FranciscoVentures/EN7767/Hardware/GPS.sch

## KiCad design Hardware/GPS.sch (2021-01-12)

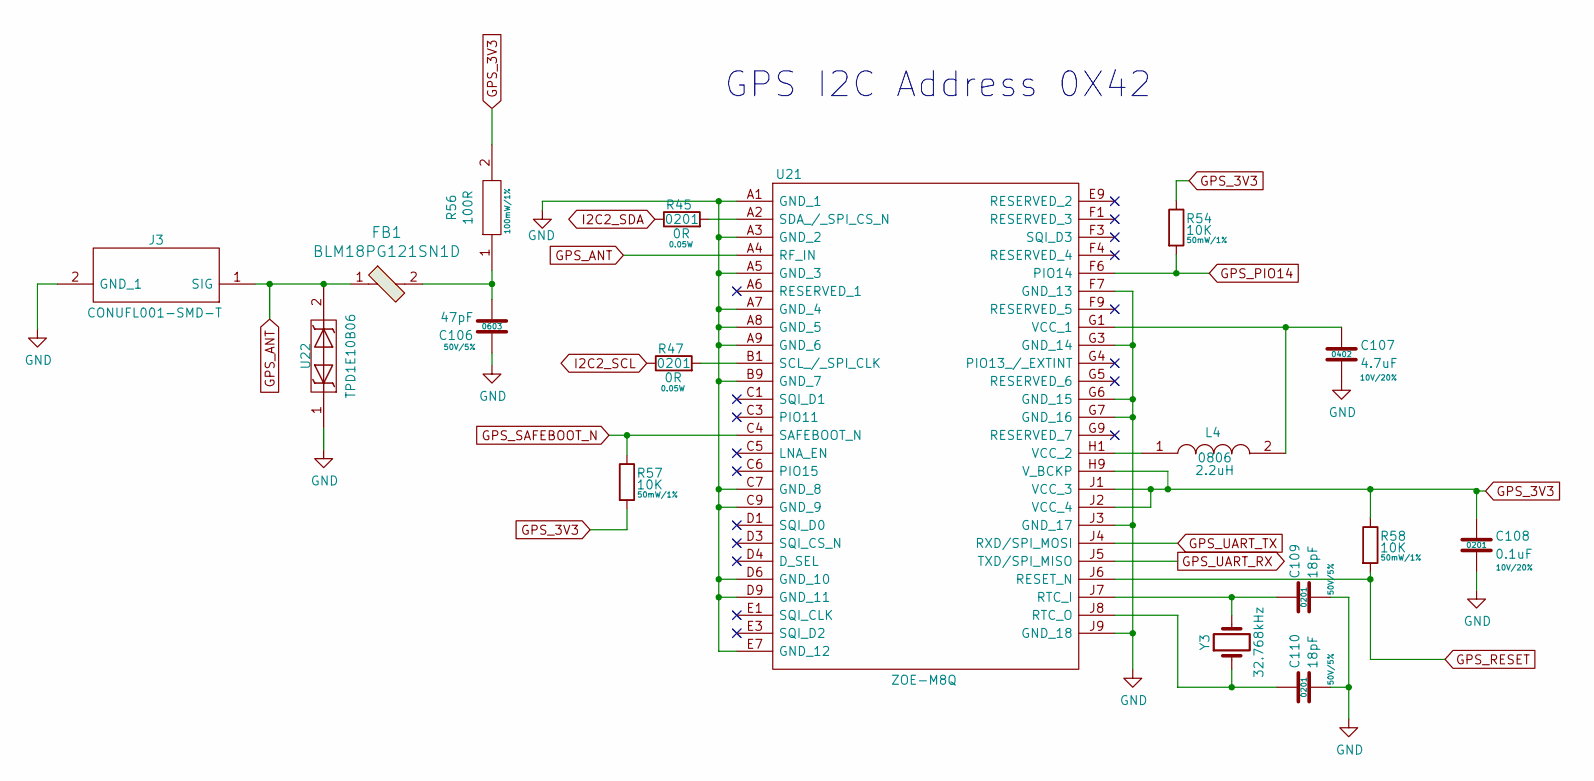
[picture p1: schematic GPS.sch]

Parts:
C106: 47pF; 0603; Rating 50V/5%; Mfg PN C0603C470J5GACTU; Digi-Key_PN 399-1056-1-ND
C107: 4.7uF; SM0402; Rating 10V/20%; Mfg PN ZRB15XR61A475ME01D; Digi-Key_PN 490-10984-1-ND
C108: 0.1uF; SM0201; Rating 10V/20%; Mfg PN GRM033R61A104ME15D; Digi-Key_PN 490-5405-1-ND
C109, C110: 18pF; SM0201; Rating 50V/5%; Mfg PN GRM0335C1H180JA01D; Digi-Key_PN 490-6117-1-ND
FB1: BLM18PG121SN1D; 0603; Mfg PN BLM18PG121SN1D; Digi-Key_PN 490-1037-1-ND
J3: CONUFL001-SMD-T; U.FL_Molex_MCRF_73412-0110_Vertical; Mouser Part Number 712-CONUFL001-SMD-T
L4: 2.2uH; INDC2016X180N; Rating 0806; Mfg PN LQM2MPN2R2NG0L; Digi-Key_PN 490-7786-1-ND
R45, R47: 0R; R_0201_0603Metric; Rating 0.05W; Mfg PN CRCW02010000Z0ED; Digi-Key_PN 541-0.0AGCT-ND
R54, R57, R58: 10K; R_0201_0603Metric; Rating 50mW/1%; Mfg PN CRCW020110K0JNED; Digi-Key_PN 541-10KAGCT-ND
R56: 100R; 0603; Rating 100mW/1%; Mfg PN RC0603FR-07100RL; Digi-Key_PN 311-100HRCT-ND
U21: ZOE-M8Q; ZOEM8B; Mfg PN ZOE-M8Q-0-10; Digi-Key_PN 672-ZOE-M8Q-0-10CT-ND
U22: TPD1E10B06; X1SON-2; Mfg PN TPD1E10B06DPYR; Digi-Key_PN 296-30406-1-ND
Y3: 32.768kHz; CM7V-T1A; Mfg PN CM7V-T1A-32.768KHZ-12.5PF-20PPM-TB-QA; Digi-Key_PN 2195-CM7V-T1A-32.768KHZ-12.5PF-20PPM-TB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

Connections:
GND: C106.1, C107.2, C108.2, C109.2, C110.2, J3.2 (GND_1), U21.A1 (GND_1), U21.A3 (GND_2), U21.A5 (GND_3), U21.A7 (GND_4), U21.A8 (GND_5), U21.A9 (GND_6), U21.B9 (GND_7), U21.C7 (GND_8), U21.C9 (GND_9), U21.D6 (GND_10), U21.D9 (GND_11), U21.E7 (GND_12), U21.F7 (GND_13), U21.G3 (GND_14), U21.G6 (GND_15), U21.G7 (GND_16), U21.J3 (GND_17), U21.J9 (GND_18), U22.1
GPS_3V3: C108.1, R54.1, R56.2, R57.2, R58.1, U21.H9 (V_BCKP), U21.J1 (VCC_3), U21.J2 (VCC_4)
GPS_ANT: FB1.1, J3.1 (SIG), U21.A4 (RF_IN), U22.2
GPS_PIO14: R54.2, U21.F6 (PIO14)
GPS_RESET: R58.2, U21.J6 (RESET_N)
GPS_SAFEBOOT_N: R57.1, U21.C4 (SAFEBOOT_N)
GPS_UART_RX: U21.J5 (TXD/SPI_MISO)
GPS_UART_TX: U21.J4 (RXD/SPI_MOSI)
I2C2_SCL: R47.1
I2C2_SDA: R45.1
unnamed: C106.2, FB1.2, R56.1
unnamed: C107.1, L4.2, U21.G1 (VCC_1)
unnamed: C109.1, U21.J7 (RTC_I), Y3.2
unnamed: C110.1, U21.J8 (RTC_O), Y3.1
unnamed: L4.1, U21.H1 (VCC_2)
unnamed: R45.2, U21.A2 (SDA_/_SPI_CS_N)
unnamed: R47.2, U21.B1 (SCL_/_SPI_CLK)

Notes on the sheet:
GPS I2C Address 0X42
