FranciscoVentures/EN7767/Hardware/boot.sch

## KiCad design Hardware/boot.sch (2021-01-12)

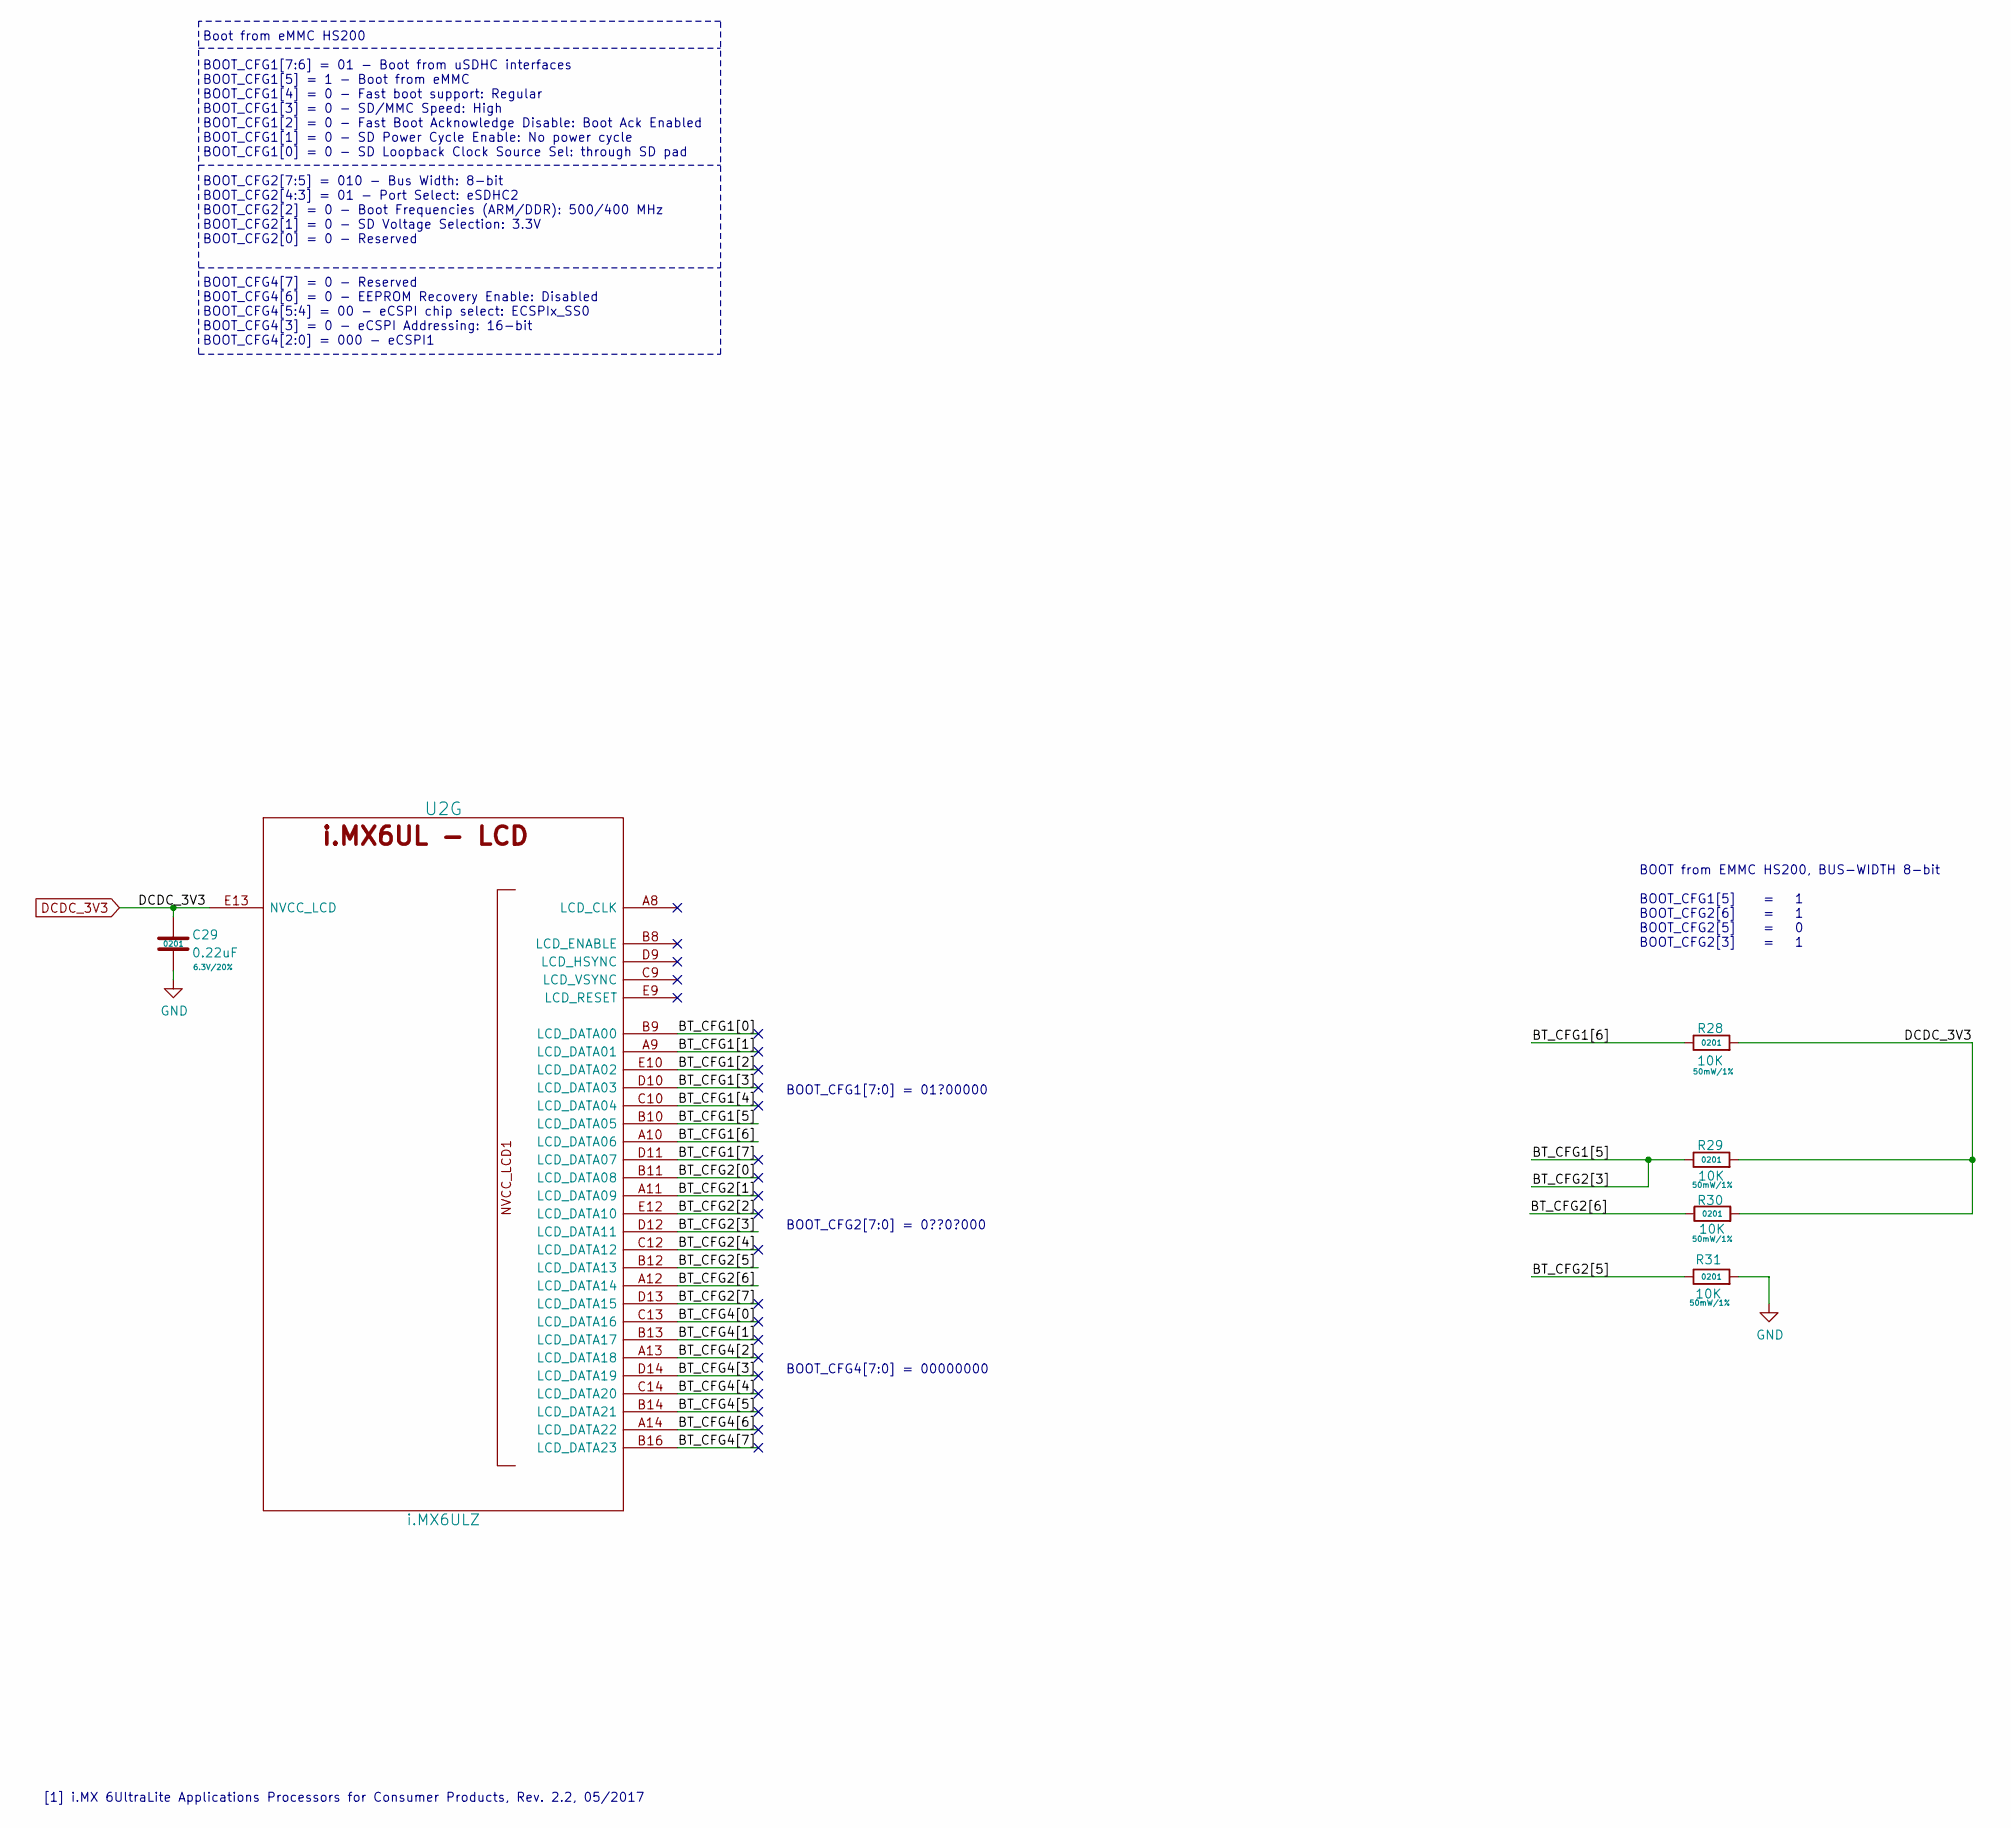
[picture p2: schematic boot.sch]

Parts:
C29: 0.22uF; SM0201; Rating 6.3V/20%; Mfg PN GRM033R60J224ME15D; Digi-Key_PN 490-10407-1-ND
R28, R29, R30, R31: 10K; R_0201_0603Metric; Rating 50mW/1%; Mfg PN CRCW020110K0JNED; Digi-Key_PN 541-10KAGCT-ND
U2: i.MX6ULZ; SOT1534-2; Mfg PN MCIMX6Z0DVM09AB; Digi-Key_PN 568-14726-ND

Connections:
BT_CFG1[0]: U2.B9 (LCD_DATA00)
BT_CFG1[1]: U2.A9 (LCD_DATA01)
BT_CFG1[2]: U2.E10 (LCD_DATA02)
BT_CFG1[3]: U2.D10 (LCD_DATA03)
BT_CFG1[4]: U2.C10 (LCD_DATA04)
BT_CFG1[5]: R29.1, U2.B10 (LCD_DATA05), U2.D12 (LCD_DATA11)
BT_CFG1[6]: R28.1, U2.A10 (LCD_DATA06)
BT_CFG1[7]: U2.D11 (LCD_DATA07)
BT_CFG2[0]: U2.B11 (LCD_DATA08)
BT_CFG2[1]: U2.A11 (LCD_DATA09)
BT_CFG2[2]: U2.E12 (LCD_DATA10)
BT_CFG2[4]: U2.C12 (LCD_DATA12)
BT_CFG2[5]: R31.1, U2.B12 (LCD_DATA13)
BT_CFG2[6]: R30.1, U2.A12 (LCD_DATA14)
BT_CFG2[7]: U2.D13 (LCD_DATA15)
BT_CFG4[0]: U2.C13 (LCD_DATA16)
BT_CFG4[1]: U2.B13 (LCD_DATA17)
BT_CFG4[2]: U2.A13 (LCD_DATA18)
BT_CFG4[3]: U2.D14 (LCD_DATA19)
BT_CFG4[4]: U2.C14 (LCD_DATA20)
BT_CFG4[5]: U2.B14 (LCD_DATA21)
BT_CFG4[6]: U2.A14 (LCD_DATA22)
BT_CFG4[7]: U2.B16 (LCD_DATA23)
DCDC_3V3: C29.1, R28.2, R29.2, R30.2, U2.E13 (NVCC_LCD)
GND: C29.2, R31.2

Notes on the sheet:
Boot from eMMC HS200 BOOT_CFG1[7:6] = 01 - Boot from uSDHC interfaces BOOT_CFG1[5] = 1 - Boot from eMMC BOOT_CFG1[4] = 0 - Fast boot support: Regular BOOT_CFG1[3] = 0 - SD/MMC Speed: High BOOT_CFG1[2] = 0 - Fast Boot Acknowledge Disable: Boot Ack Enabled BOOT_CFG1[1] = 0 - SD Power Cycle Enable: No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
BOOT_CFG4[7:0] = 00000000
BOOT from EMMC HS200, BUS-WIDTH 8-bit BOOT_CFG1[5] = 1 BOOT_CFG2[6] = 1 BOOT_CFG2[5] = 0 BOOT_CFG2[3] = 1
BOOT_CFG2[7:0] = 0??0?000
BOOT_CFG1[7:0] = 01?00000
[1] i.MX 6UltraLite Applications Processors for Consumer Products, Rev. 2.2, 05/2017
