FranciscoVentures/EN7767/Hardware/crystals.sch

## KiCad design Hardware/crystals.sch (2021-01-12)

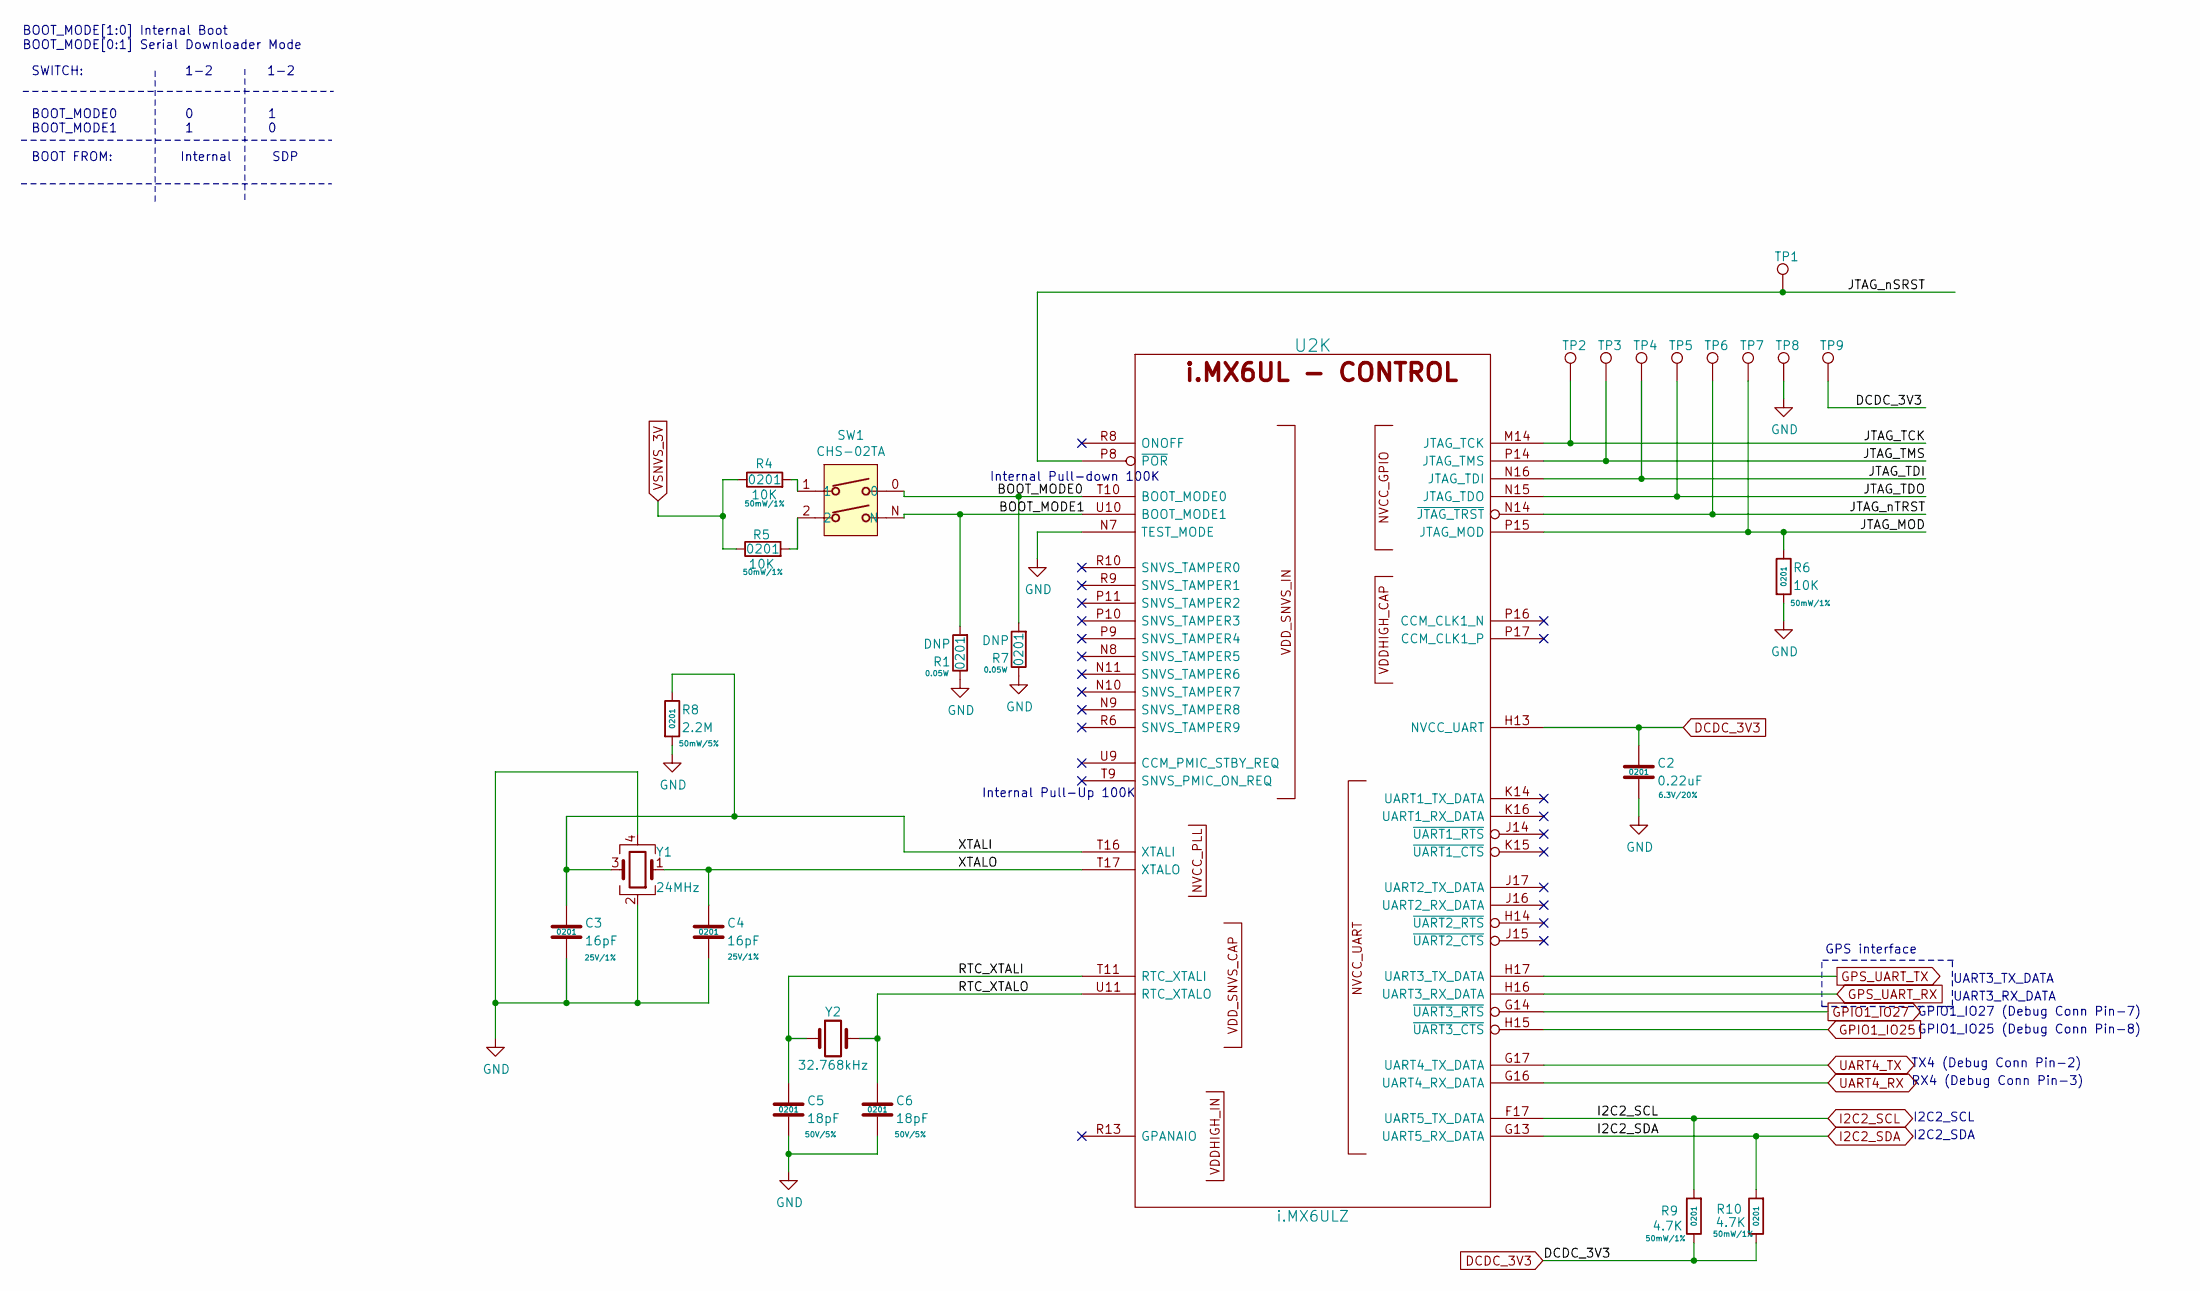
[picture p3: schematic crystals.sch]

Parts:
C2: 0.22uF; SM0201; Rating 6.3V/20%; Mfg PN GRM033R60J224ME15D; Digi-Key_PN 490-10407-1-ND
C3, C4: 16pF; SM0201; Rating 25V/1%; Mfg PN CBR02C160F3GAC; Digi-Key_PN 399-8574-1-ND
C5, C6: 18pF; SM0201; Rating 50V/5%; Mfg PN GRM0335C1H180JA01D; Digi-Key_PN 490-6117-1-ND
R1, R7: DNP; R_0201_0603Metric; Rating 0.05W; Mfg PN CRCW02010000Z0ED; Digi-Key_PN 541-0.0AGCT-ND
R4, R5, R6: 10K; R_0201_0603Metric; Rating 50mW/1%; Mfg PN CRCW020110K0JNED; Digi-Key_PN 541-10KAGCT-ND
R8: 2.2M; R_0201_0603Metric; Rating 50mW/5%; Mfg PN RC0201JR-072M2L; Digi-Key_PN YAG2882CT-ND
R9, R10: 4.7K; R_0201_0603Metric; Rating 50mW/1%; Mfg PN CRCW02014K70JNED; Digi-Key_PN 541-4.7KAGCT-ND
SW1: CHS-02TA; Mfg PN CHS-02TA; Digi-Key_PN 563-1005-2-ND
TP1, TP2, TP3, TP4, TP5, TP6, TP7, TP8, TP9: TestPoint; TP
U2: i.MX6ULZ; SOT1534-2; Mfg PN MCIMX6Z0DVM09AB; Digi-Key_PN 568-14726-ND
Y1: 24MHz; TSX-3225; Mfg PN TSX-3225 24.0000MF15X-AC3; Digi-Key_PN SER3635TR-ND
Y2: 32.768kHz; CM7V-T1A; Mfg PN CM7V-T1A-32.768KHZ-12.5PF-20PPM-TB-QA; Digi-Key_PN 2195-CM7V-T1A-32.768KHZ-12.5PF-20PPM-TB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

Connections:
BOOT_MODE0: R7.2, SW1.0, U2.T10 (BOOT_MODE0)
BOOT_MODE1: R1.2, SW1.N, U2.U10 (BOOT_MODE1)
DCDC_3V3: C2.1, R9.1, R10.1, TP9.1, U2.H13 (NVCC_UART)
GND: C2.2, C3.2, C4.2, C5.2, C6.2, R1.1, R6.2, R7.1, R8.2, TP8.1, U2.N7 (TEST_MODE), Y1.2, Y1.4
GPIO1_IO25: U2.H15 (~UART3_CTS)
GPIO1_IO27: U2.G14 (~UART3_RTS)
GPS_UART_RX: U2.H16 (UART3_RX_DATA)
GPS_UART_TX: U2.H17 (UART3_TX_DATA)
I2C2_SCL: R9.2, U2.F17 (UART5_TX_DATA)
I2C2_SDA: R10.2, U2.G13 (UART5_RX_DATA)
JTAG_MOD: R6.1, TP7.1, U2.P15 (JTAG_MOD)
JTAG_TCK: TP2.1, U2.M14 (JTAG_TCK)
JTAG_TDI: TP4.1, U2.N16 (JTAG_TDI)
JTAG_TDO: TP5.1, U2.N15 (JTAG_TDO)
JTAG_TMS: TP3.1, U2.P14 (JTAG_TMS)
JTAG_nSRST: TP1.1, U2.P8 (~POR)
JTAG_nTRST: TP6.1, U2.N14 (~JTAG_TRST)
unnamed: R4.2, SW1.1
unnamed: R5.2, SW1.2
RTC_XTALI: C5.1, U2.T11 (RTC_XTALI), Y2.1
RTC_XTALO: C6.1, U2.U11 (RTC_XTALO), Y2.2
UART4_RX: U2.G16 (UART4_RX_DATA)
UART4_TX: U2.G17 (UART4_TX_DATA)
VSNVS_3V: R4.1, R5.1
XTALI: C3.1, R8.1, U2.T16 (XTALI), Y1.3
XTALO: C4.1, U2.T17 (XTALO), Y1.1

Notes on the sheet:
BOOT_MODE[1:0] Internal Boot BOOT_MODE[0:1] Serial Downloader Mode
GPS interface
UART3_TX_DATA
UART3_RX_DATA
SWITCH: 1-2 1-2 BOOT_MODE0 0 1 BOOT_MODE1 1 0 BOOT FROM: Internal SDP
GPIO1_IO27 (Debug Conn Pin-7)
RX4 (Debug Conn Pin-3)
TX4 (Debug Conn Pin-2)
I2C2_SDA
I2C2_SCL
Internal Pull-down 100K
Internal Pull-Up 100K
GPIO1_IO25 (Debug Conn Pin-8)
