FranciscoVentures/EN7767/Hardware/ddr.sch

## KiCad design Hardware/ddr.sch (2021-01-12)

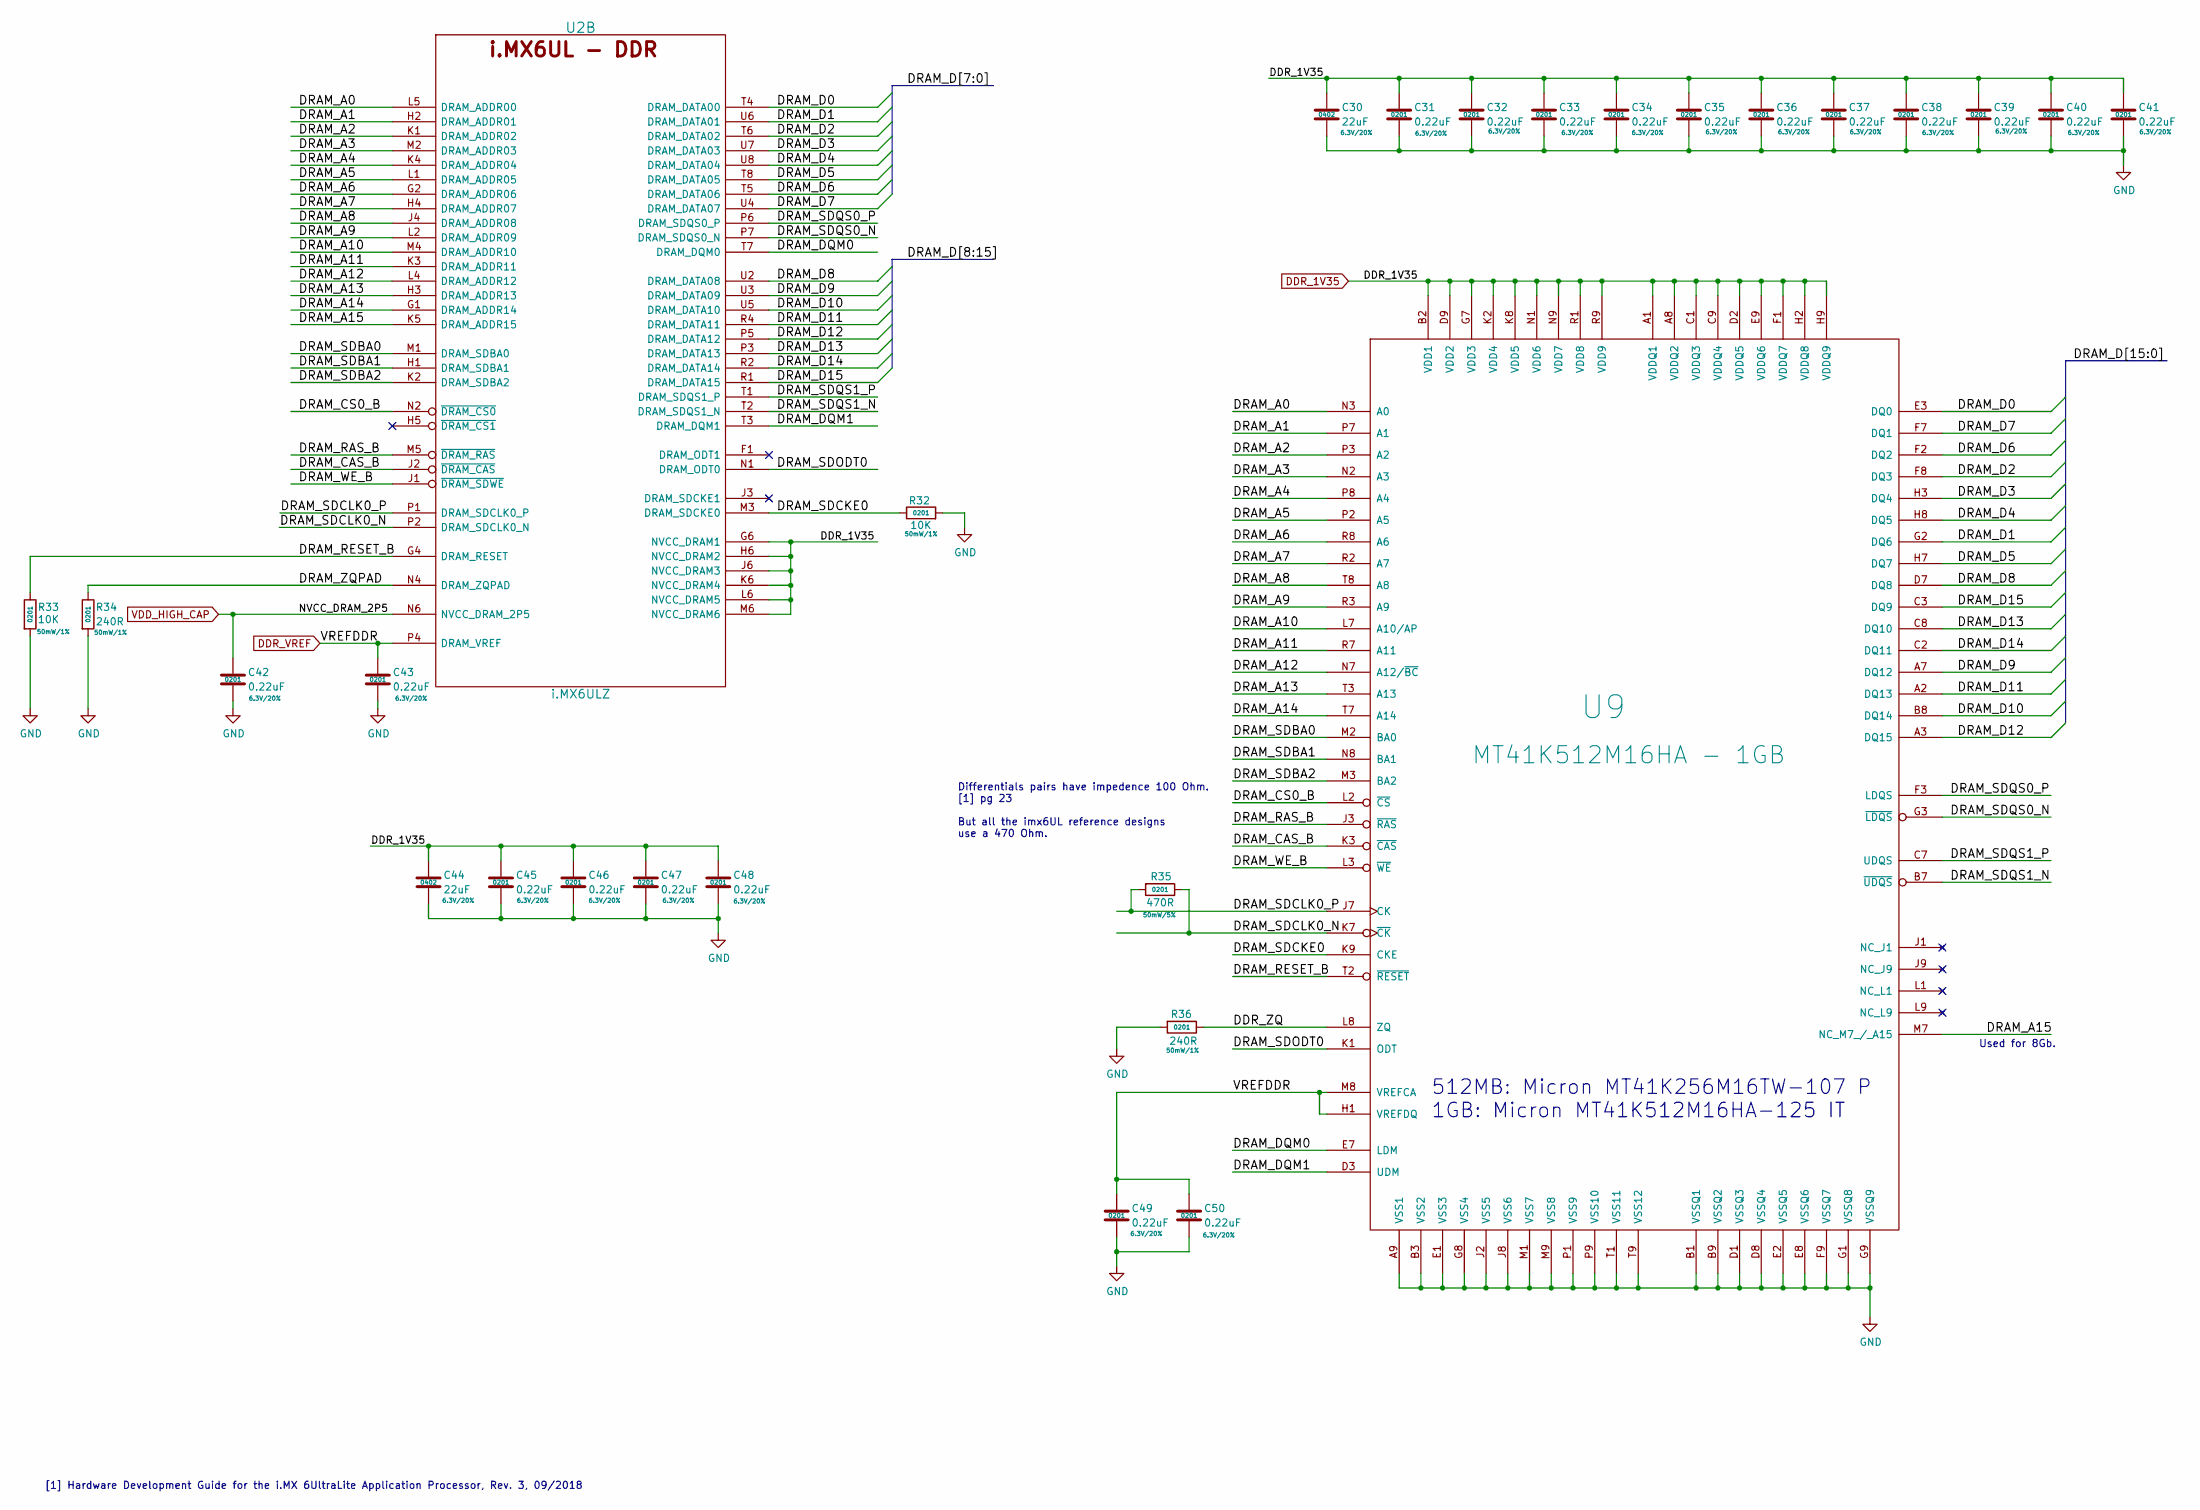
[picture p4: schematic ddr.sch]

Parts:
C30, C44: 22uF; SM0402; Rating 6.3V/20%; Mfg PN CL05A226MQ5N6J8; Digi-Key_PN 1276-7090-1-ND
C31, C32, C33, C34, C35, C36, C37, C38, C39, C40, C41, C42, C43, C45, C46, C47, C48, C49, C50: 0.22uF; SM0201; Rating 6.3V/20%; Mfg PN GRM033R60J224ME15D; Digi-Key_PN 490-10407-1-ND
R32, R33: 10K; R_0201_0603Metric; Rating 50mW/1%; Mfg PN CRCW020110K0JNED; Digi-Key_PN 541-10KAGCT-ND
R34, R36: 240R; R_0201_0603Metric; Rating 50mW/1%; Mfg PN CRCW0201240RFNED; Digi-Key_PN 541-2949-1-ND
R35: 470R; R_0201_0603Metric; Rating 50mW/5%; Mfg PN CRCW0201470RJNED; Digi-Key_PN 541-470AGCT-ND
U2: i.MX6ULZ; SOT1534-2; Mfg PN MCIMX6Z0DVM09AB; Digi-Key_PN 568-14726-ND
U9: MT41K512M16HA - 1GB; MICRON-FBGA-96; Mfg PN MT41K512M16HA-125 IT:A; Digi-Key_PN MT41K512M16HA-125IT:A-ND

Connections:
DDR_1V35: C30.1, C31.1, C32.1, C33.1, C34.1, C35.1, C36.1, C37.1, C38.1, C39.1, C40.1, C41.1, C44.1, C45.1, C46.1, C47.1, C48.1, U2.G6 (NVCC_DRAM1), U2.H6 (NVCC_DRAM2), U2.J6 (NVCC_DRAM3), U2.K6 (NVCC_DRAM4), U2.L6 (NVCC_DRAM5), U2.M6 (NVCC_DRAM6), U9.A1 (VDDQ1), U9.A8 (VDDQ2), U9.B2 (VDD1), U9.C1 (VDDQ3), U9.C9 (VDDQ4), U9.D2 (VDDQ5), U9.D9 (VDD2), U9.E9 (VDDQ6), U9.F1 (VDDQ7), U9.G7 (VDD3), U9.H2 (VDDQ8), U9.H9 (VDDQ9), U9.K2 (VDD4), U9.K8 (VDD5), U9.N1 (VDD6), U9.N9 (VDD7), U9.R1 (VDD8), U9.R9 (VDD9)
DDR_VREF: C43.1, C49.1, C50.1, U2.P4 (DRAM_VREF), U9.H1 (VREFDQ), U9.M8 (VREFCA)
DDR_ZQ: R36.1, U9.L8 (ZQ)
DRAM_A0: U2.L5 (DRAM_ADDR00), U9.N3 (A0)
DRAM_A1: U2.H2 (DRAM_ADDR01), U9.P7 (A1)
DRAM_A2: U2.K1 (DRAM_ADDR02), U9.P3 (A2)
DRAM_A3: U2.M2 (DRAM_ADDR03), U9.N2 (A3)
DRAM_A4: U2.K4 (DRAM_ADDR04), U9.P8 (A4)
DRAM_A5: U2.L1 (DRAM_ADDR05), U9.P2 (A5)
DRAM_A6: U2.G2 (DRAM_ADDR06), U9.R8 (A6)
DRAM_A7: U2.H4 (DRAM_ADDR07), U9.R2 (A7)
DRAM_A8: U2.J4 (DRAM_ADDR08), U9.T8 (A8)
DRAM_A9: U2.L2 (DRAM_ADDR09), U9.R3 (A9)
DRAM_A10: U2.M4 (DRAM_ADDR10), U9.L7 (A10/AP)
DRAM_A11: U2.K3 (DRAM_ADDR11), U9.R7 (A11)
DRAM_A12: U2.L4 (DRAM_ADDR12), U9.N7 (A12/~BC)
DRAM_A13: U2.H3 (DRAM_ADDR13), U9.T3 (A13)
DRAM_A14: U2.G1 (DRAM_ADDR14), U9.T7 (A14)
DRAM_A15: U2.K5 (DRAM_ADDR15), U9.M7 (NC_M7_/_A15)
DRAM_CAS_B: U2.J2 (~DRAM_CAS), U9.K3 (~CAS)
DRAM_CS0_B: U2.N2 (~DRAM_CS0), U9.L2 (~CS)
DRAM_D0: U2.T4 (DRAM_DATA00), U9.E3 (DQ0)
DRAM_D1: U2.U6 (DRAM_DATA01), U9.G2 (DQ6)
DRAM_D2: U2.T6 (DRAM_DATA02), U9.F8 (DQ3)
DRAM_D3: U2.U7 (DRAM_DATA03), U9.H3 (DQ4)
DRAM_D4: U2.U8 (DRAM_DATA04), U9.H8 (DQ5)
DRAM_D5: U2.T8 (DRAM_DATA05), U9.H7 (DQ7)
DRAM_D6: U2.T5 (DRAM_DATA06), U9.F2 (DQ2)
DRAM_D7: U2.U4 (DRAM_DATA07), U9.F7 (DQ1)
DRAM_D8: U2.U2 (DRAM_DATA08), U9.D7 (DQ8)
DRAM_D9: U2.U3 (DRAM_DATA09), U9.A7 (DQ12)
DRAM_D10: U2.U5 (DRAM_DATA10), U9.B8 (DQ14)
DRAM_D11: U2.R4 (DRAM_DATA11), U9.A2 (DQ13)
DRAM_D12: U2.P5 (DRAM_DATA12), U9.A3 (DQ15)
DRAM_D13: U2.P3 (DRAM_DATA13), U9.C8 (DQ10)
DRAM_D14: U2.R2 (DRAM_DATA14), U9.C2 (DQ11)
DRAM_D15: U2.R1 (DRAM_DATA15), U9.C3 (DQ9)
DRAM_DQM0: U2.T7 (DRAM_DQM0), U9.E7 (LDM)
DRAM_DQM1: U2.T3 (DRAM_DQM1), U9.D3 (UDM)
DRAM_RAS_B: U2.M5 (~DRAM_RAS), U9.J3 (~RAS)
DRAM_RESET_B: R33.1, U2.G4 (DRAM_RESET), U9.T2 (~RESET)
DRAM_SDBA0: U2.M1 (DRAM_SDBA0), U9.M2 (BA0)
DRAM_SDBA1: U2.H1 (DRAM_SDBA1), U9.N8 (BA1)
DRAM_SDBA2: U2.K2 (DRAM_SDBA2), U9.M3 (BA2)
DRAM_SDCKE0: R32.1, U2.M3 (DRAM_SDCKE0), U9.K9 (CKE)
DRAM_SDCLK0_N: R35.1, U2.P2 (DRAM_SDCLK0_N), U9.K7 (~CK)
DRAM_SDCLK0_P: R35.2, U2.P1 (DRAM_SDCLK0_P), U9.J7 (CK)
DRAM_SDODT0: U2.N1 (DRAM_ODT0), U9.K1 (ODT)
DRAM_SDQS0_N: U2.P7 (DRAM_SDQS0_N), U9.G3 (~LDQS)
DRAM_SDQS0_P: U2.P6 (DRAM_SDQS0_P), U9.F3 (LDQS)
DRAM_SDQS1_N: U2.T2 (DRAM_SDQS1_N), U9.B7 (~UDQS)
DRAM_SDQS1_P: U2.T1 (DRAM_SDQS1_P), U9.C7 (UDQS)
DRAM_WE_B: U2.J1 (~DRAM_SDWE), U9.L3 (~WE)
DRAM_ZQPAD: R34.1, U2.N4 (DRAM_ZQPAD)
GND: C30.2, C31.2, C32.2, C33.2, C34.2, C35.2, C36.2, C37.2, C38.2, C39.2, C40.2, C41.2, C42.2, C43.2, C44.2, C45.2, C46.2, C47.2, C48.2, C49.2, C50.2, R32.2, R33.2, R34.2, R36.2, U9.A9 (VSS1), U9.B1 (VSSQ1), U9.B3 (VSS2), U9.B9 (VSSQ2), U9.D1 (VSSQ3), U9.D8 (VSSQ4), U9.E1 (VSS3), U9.E2 (VSSQ5), U9.E8 (VSSQ6), U9.F9 (VSSQ7), U9.G1 (VSSQ8), U9.G8 (VSS4), U9.G9 (VSSQ9), U9.J2 (VSS5), U9.J8 (VSS6), U9.M1 (VSS7), U9.M9 (VSS8), U9.P1 (VSS9), U9.P9 (VSS10), U9.T1 (VSS11), U9.T9 (VSS12)
VDD_HIGH_CAP: C42.1, U2.N6 (NVCC_DRAM_2P5)

Notes on the sheet:
Used for 8Gb.
512MB: Micron MT41K256M16TW-107 P 1GB: Micron MT41K512M16HA-125 IT
[1] Hardware Development Guide for the i.MX 6UltraLite Application Processor, Rev. 3, 09/2018
Differentials pairs have impedence 100 Ohm. [1] pg 23 But all the imx6UL reference designs use a 470 Ohm.
