FranciscoVentures/EN7767/Hardware/emmc.sch

## KiCad design Hardware/emmc.sch (2021-01-12)

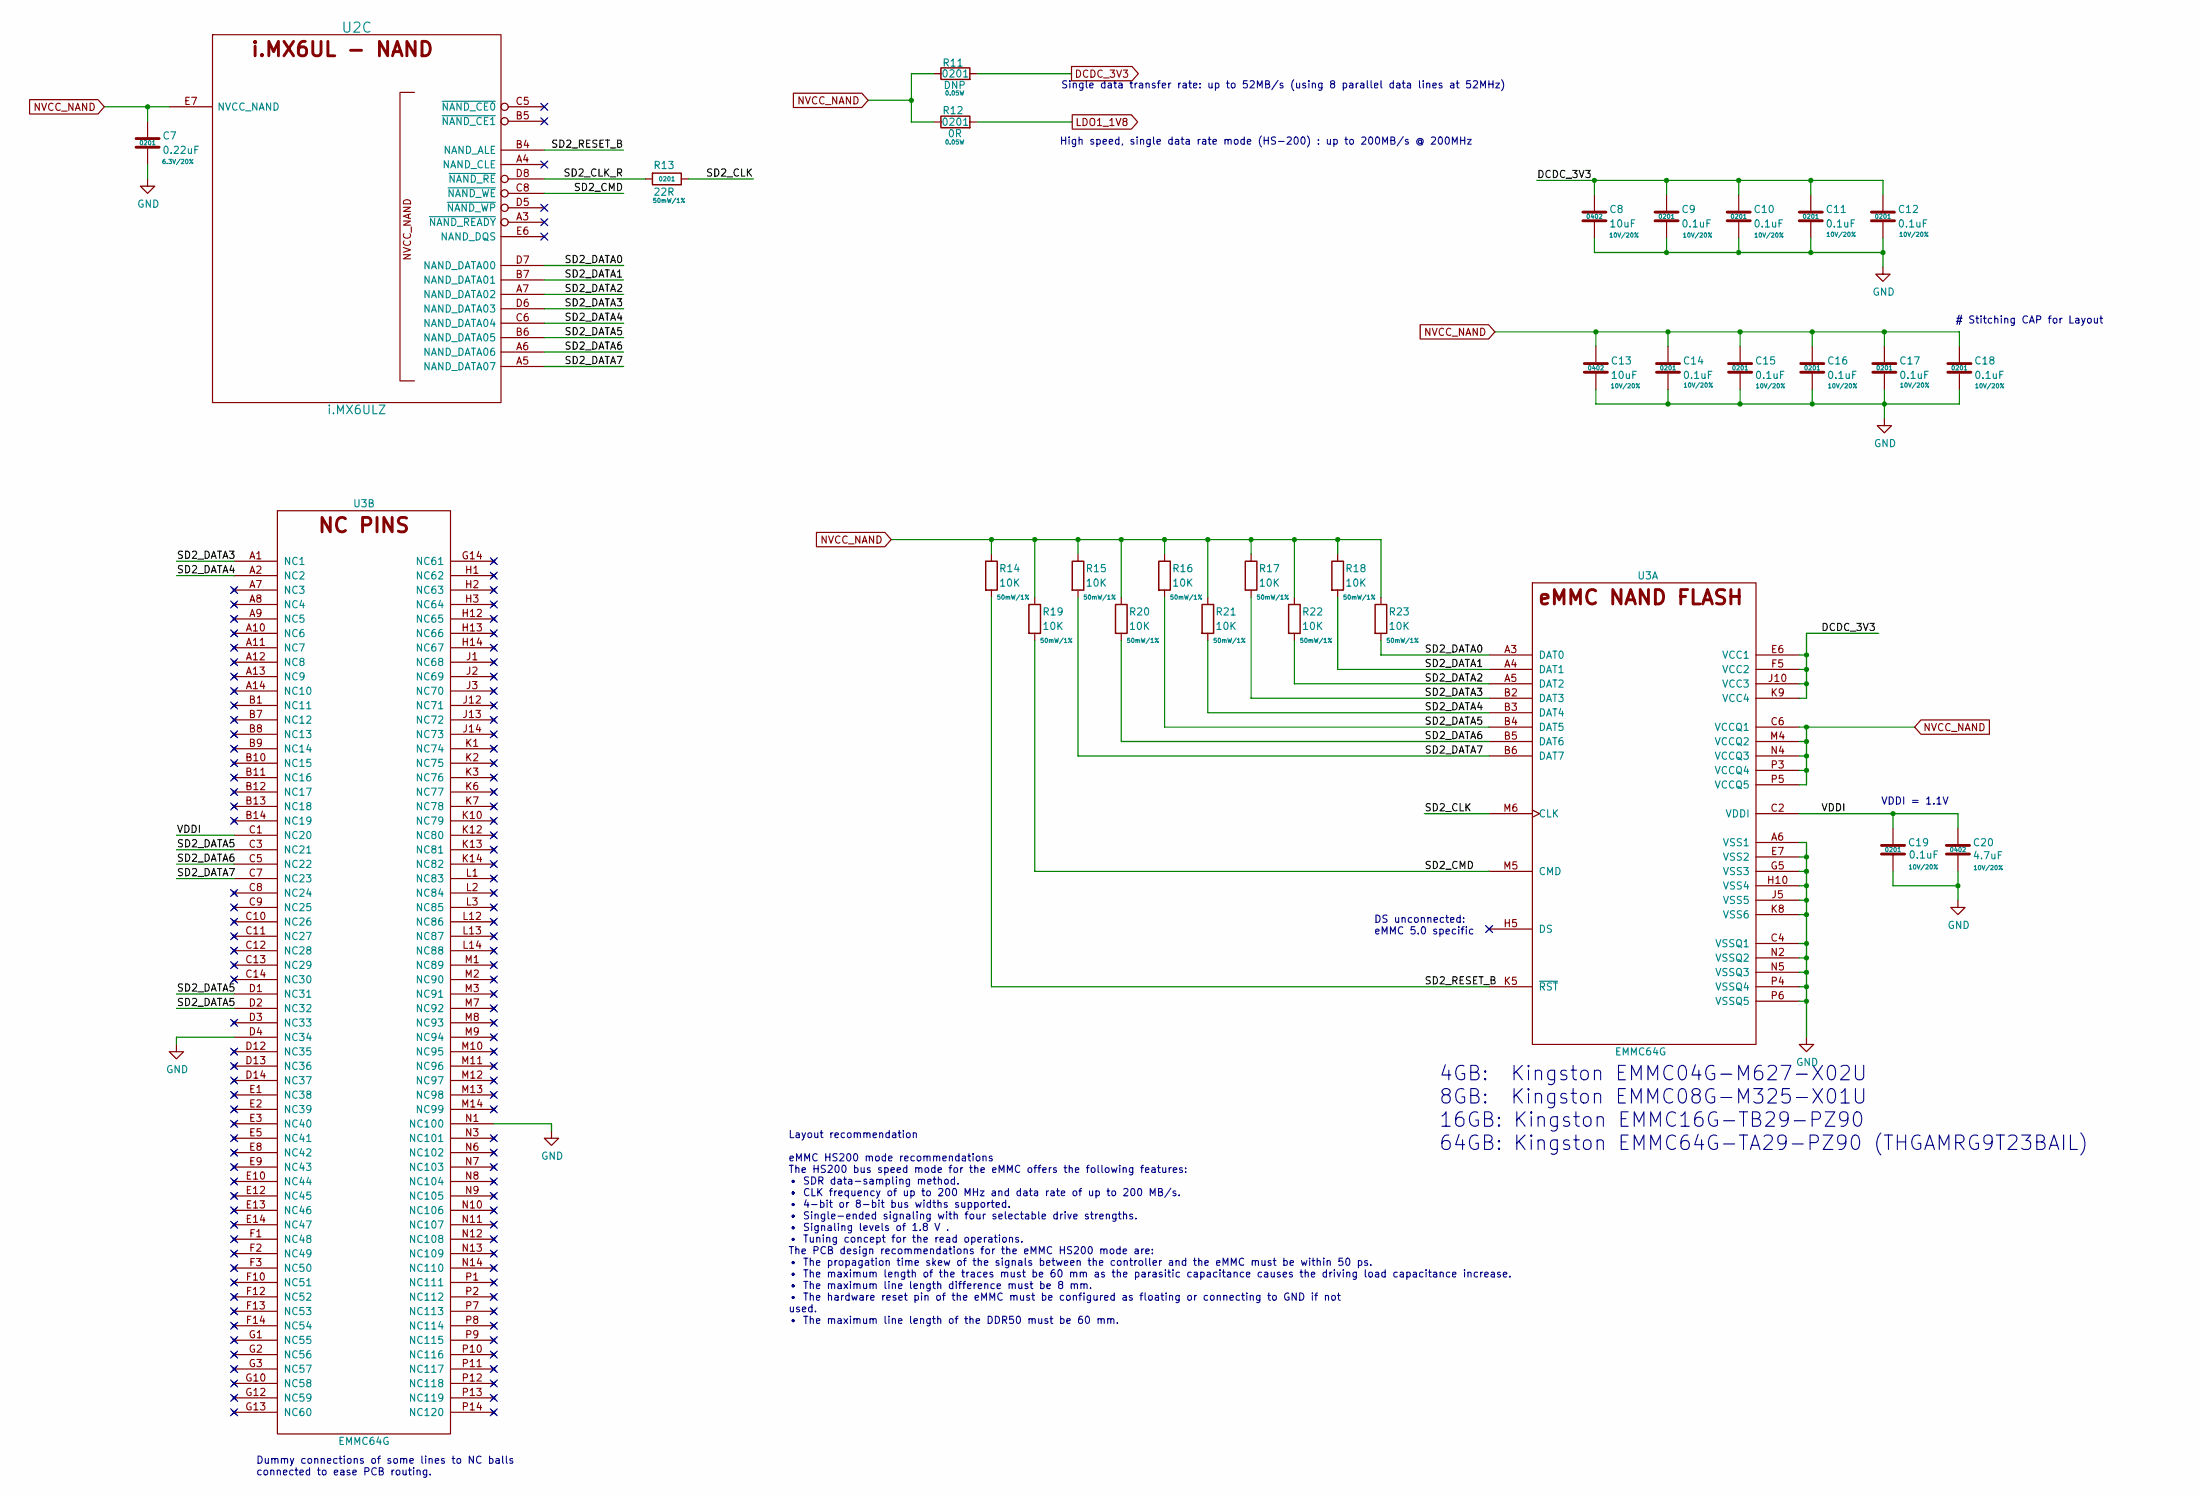
[picture p5: schematic emmc.sch]

Parts:
C7: 0.22uF; SM0201; Rating 6.3V/20%; Mfg PN GRM033R60J224ME15D; Digi-Key_PN 490-10407-1-ND
C8, C13: 10uF; SM0402; Rating 10V/20%; Mfg PN CL05A106MP8NUB8; Digi-Key_PN 1276-6830-1-ND
C9, C10, C11, C12, C14, C15, C16, C17, C18, C19: 0.1uF; SM0201; Rating 10V/20%; Mfg PN GRM033R61A104ME15D; Digi-Key_PN 490-5405-1-ND
C20: 4.7uF; SM0402; Rating 10V/20%; Mfg PN ZRB15XR61A475ME01D; Digi-Key_PN 490-10984-1-ND
R11: DNP; R_0201_0603Metric; Rating 0.05W; Mfg PN CRCW02010000Z0ED; Digi-Key_PN 541-0.0AGCT-ND
R12: 0R; R_0201_0603Metric; Rating 0.05W; Mfg PN CRCW02010000Z0ED; Digi-Key_PN 541-0.0AGCT-ND
R13: 22R; R_0201_0603Metric; Rating 50mW/1%; Mfg PN CRCW020122R0JNED; Digi-Key_PN 541-22AGCT-ND
R14, R15, R16, R17, R18, R19, R20, R21, R22, R23: 10K; R_0201_0603Metric; Rating 50mW/1%; Mfg PN CRCW020110K0JNED; Digi-Key_PN 541-10KAGCT-ND
U2: i.MX6ULZ; SOT1534-2; Mfg PN MCIMX6Z0DVM09AB; Digi-Key_PN 568-14726-ND
U3: EMMC64G; FBGA-153; Mfg PN THGAMRG9T23BAIL; Digi-Key_PN THGAMRG9T23BAIL-ND

Connections:
DCDC_3V3: C8.1, C9.1, C10.1, C11.1, C12.1, R11.2, U3.E6 (VCC1), U3.F5 (VCC2), U3.J10 (VCC3), U3.K9 (VCC4)
GND: C7.2, C8.2, C9.2, C10.2, C11.2, C12.2, C13.2, C14.2, C15.2, C16.2, C17.2, C18.2, C19.2, C20.2, U3.A6 (VSS1), U3.C4 (VSSQ1), U3.D4 (NC34), U3.E7 (VSS2), U3.G5 (VSS3), U3.H10 (VSS4), U3.J5 (VSS5), U3.K8 (VSS6), U3.N1 (NC100), U3.N2 (VSSQ2), U3.N5 (VSSQ3), U3.P4 (VSSQ4), U3.P6 (VSSQ5)
LDO1_1V8: R12.2
NVCC_NAND: C7.1, C13.1, C14.1, C15.1, C16.1, C17.1, C18.1, R11.1, R12.1, R14.1, R15.1, R16.1, R17.1, R18.1, R19.1, R20.1, R21.1, R22.1, R23.1, U2.E7 (NVCC_NAND), U3.C6 (VCCQ1), U3.M4 (VCCQ2), U3.N4 (VCCQ3), U3.P3 (VCCQ4), U3.P5 (VCCQ5)
SD2_CLK: R13.1, U3.M6 (CLK)
SD2_CLK_R: R13.2, U2.D8 (~NAND_RE)
SD2_CMD: R19.2, U2.C8 (~NAND_WE), U3.M5 (CMD)
SD2_DATA0: R23.2, U2.D7 (NAND_DATA00), U3.A3 (DAT0)
SD2_DATA1: R18.2, U2.B7 (NAND_DATA01), U3.A4 (DAT1)
SD2_DATA2: R22.2, U2.A7 (NAND_DATA02), U3.A5 (DAT2)
SD2_DATA3: R17.2, U2.D6 (NAND_DATA03), U3.A1 (NC1), U3.B2 (DAT3)
SD2_DATA4: R21.2, U2.C6 (NAND_DATA04), U3.A2 (NC2), U3.B3 (DAT4)
SD2_DATA5: R16.2, U2.B6 (NAND_DATA05), U3.B4 (DAT5), U3.C3 (NC21), U3.D1 (NC31), U3.D2 (NC32)
SD2_DATA6: R20.2, U2.A6 (NAND_DATA06), U3.B5 (DAT6), U3.C5 (NC22)
SD2_DATA7: R15.2, U2.A5 (NAND_DATA07), U3.B6 (DAT7), U3.C7 (NC23)
SD2_RESET_B: R14.2, U2.B4 (NAND_ALE), U3.K5 (~RST)
VDDI: C19.1, C20.1, U3.C1 (NC20), U3.C2 (VDDI)

Notes on the sheet:
Dummy connections of some lines to NC balls connected to ease PCB routing.
DS unconnected: eMMC 5.0 specific
4GB: Kingston EMMC04G-M627-X02U 8GB: Kingston EMMC08G-M325-X01U 16GB: Kingston EMMC16G-TB29-PZ90 64GB: Kingston EMMC64G-TA29-PZ90 (THGAMRG9T23BAIL)
# Stitching CAP for Layout
High speed, single data rate mode (HS-200) : up to 200MB/s @ 200MHz
Single data transfer rate: up to 52MB/s (using 8 parallel data lines at 52MHz)
Layout recommendation eMMC HS200 mode recommendations The HS200 bus speed mode for the eMMC offers the following features: • SDR data-sampling method. • CLK frequency of up to 200 MHz and data rate of up to 200 MB/s. • 4-bit or 8-bit bus widths supported. • Single-ended signaling with four selectab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
VDDI = 1.1V
