FranciscoVentures/EN7767/Hardware/misc.sch

## KiCad design Hardware/misc.sch (2021-01-12)

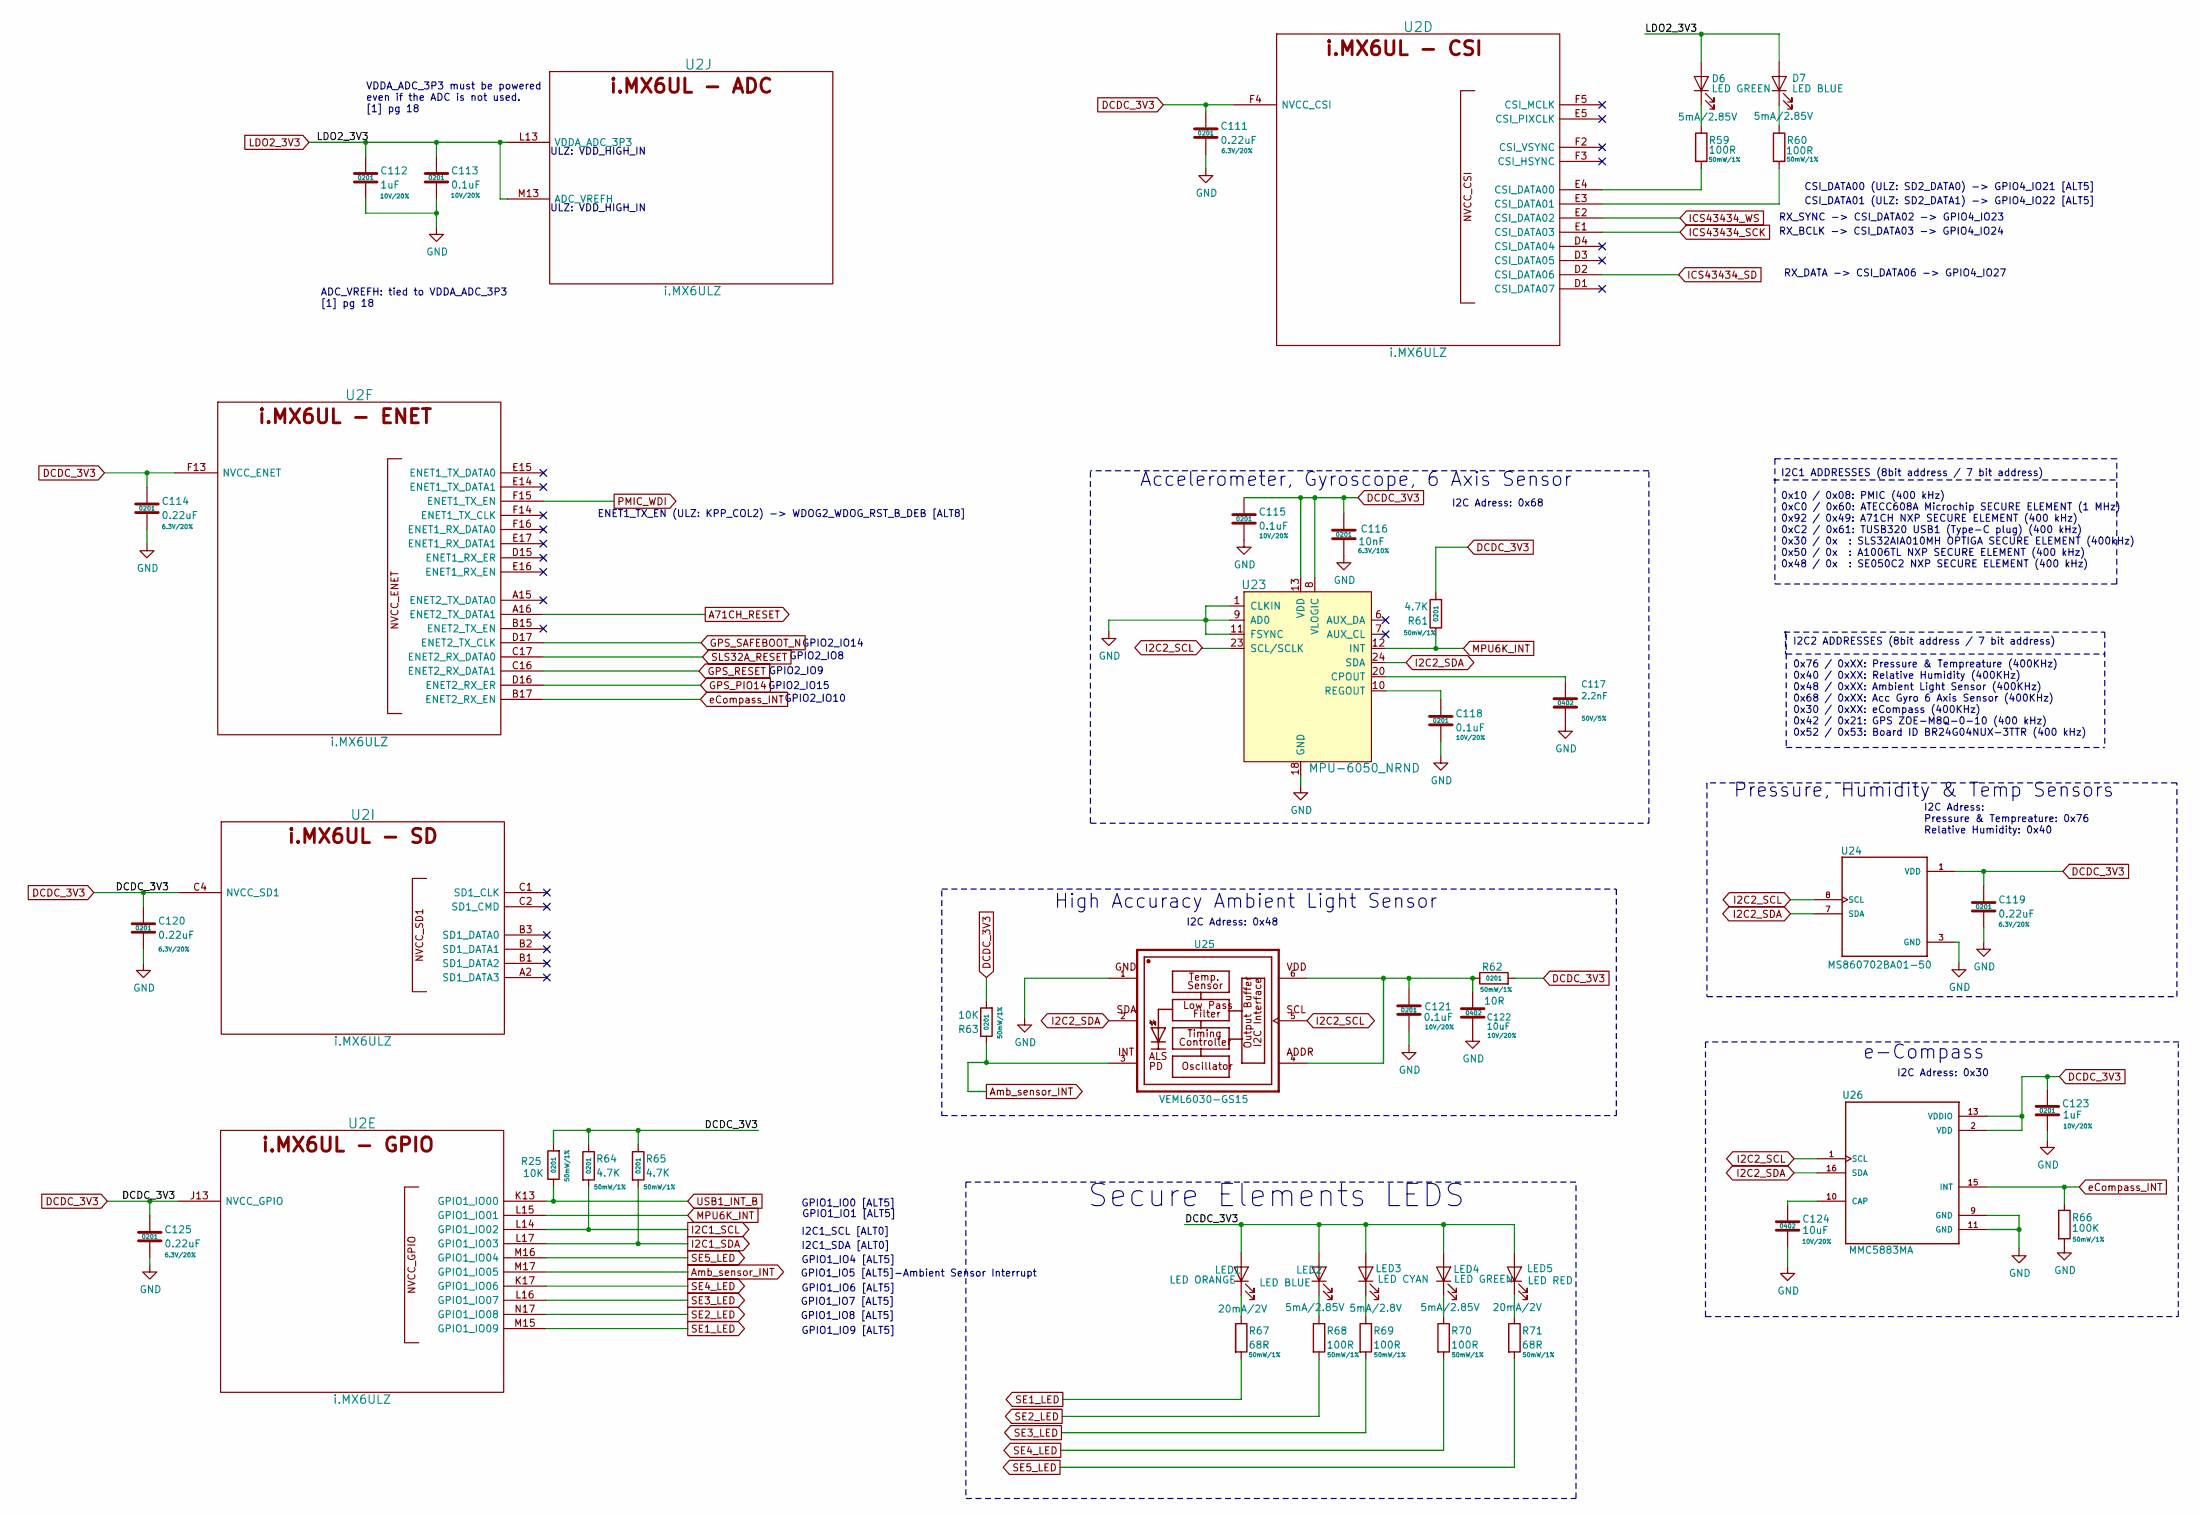
[picture p6: schematic misc.sch]

Parts:
C111, C114, C119, C120, C125: 0.22uF; SM0201; Rating 6.3V/20%; Mfg PN GRM033R60J224ME15D; Digi-Key_PN 490-10407-1-ND
C112, C123: 1uF; SM0201; Rating 10V/20%; Mfg PN CL03A105MP3ZSNH; Digi-Key_PN 1276-6816-1-ND
C113, C115, C118, C121: 0.1uF; SM0201; Rating 10V/20%; Mfg PN GRM033R61A104ME15D; Digi-Key_PN 490-5405-1-ND
C116: 10nF; SM0201; Rating 6.3V/10%; Mfg PN GRM033R70J103KA01D; Digi-Key_PN 490-1262-1-ND
C117: 2.2nF; C_0402_1005Metric; Rating 50V/5%; Mfg PN GRM155R71H222JA01J; Digi-Key_PN 490-6359-1-ND
C122: 10uF; C_0402_1005Metric; Rating 10V/20%; Mfg PN CL05A106MP8NUB8; Digi-Key_PN 1276-6830-1-ND
C124: 10uF; SM0402; Rating 10V/20%; Mfg PN CL05A106MP8NUB8; Digi-Key_PN 1276-6830-1-ND
D6: LED GREEN; LED_0603; Rating 5mA/2.85V; Mfg PN LT Q39G-Q1OO-25-1; Digi-Key_PN 475-3442-1-ND
D7: LED BLUE; SM0603_LED; Rating 5mA/2.85V; Mfg PN LB Q39G-L2OO-35-1; Digi-Key_PN 475-2816-1-ND
LED1: LED ORANGE; LED_0603; Rating 20mA/2V; Mfg PN LO Q976-PS-25-0-20-R18; Digi-Key_PN 475-2486-1-ND
LED2: LED BLUE; LED_0603; Rating 5mA/2.85V; Mfg PN LB Q39G-L2OO-35-1; Digi-Key_PN 475-2816-1-ND
LED3: LED CYAN; LED_0603; Rating 5mA/2.8V; Mfg PN APT1608VRCXF/A-5MAV; Digi-Key_PN 754-2180-1-ND
LED4: LED GREEN; LED_0603; Rating 5mA/2.85V; Mfg PN LT Q39G-Q1OO-25-1; Digi-Key_PN 475-3442-1-ND
LED5: LED RED; LED_0603; Rating 20mA/2V; Mfg PN LS Q976-NR-1; Digi-Key_PN 475-2512-1-ND
R25, R63: 10K; R_0201_0603Metric; Rating 50mW/1%; Mfg PN CRCW020110K0JNED; Digi-Key_PN 541-10KAGCT-ND
R59, R60, R68, R69, R70: 100R; R_0201_0603Metric; Rating 50mW/1%; Mfg PN CRCW0201100RFNED; Digi-Key_PN 541-100ABCT-ND
R61, R64, R65: 4.7K; R_0201_0603Metric; Rating 50mW/1%; Mfg PN CRCW02014K70JNED; Digi-Key_PN 541-4.7KAGCT-ND
R62: 10R; R_0201_0603Metric; Rating 50mW/1%; Mfg PN CRCW020110R0FNED; Digi-Key_PN 541-10.0ABCT-ND
R66: 100K; R_0201_0603Metric; Rating 50mW/1%; Mfg PN CRCW0201100KJNED; Digi-Key_PN 541-100KAGCT-ND
R67, R71: 68R; R_0201_0603Metric; Rating 50mW/1%; Mfg PN CRCW020168R0FNED; Digi-Key_PN 541-CRCW020168R0FNEDCT-ND
U2: i.MX6ULZ; SOT1534-2; Mfg PN MCIMX6Z0DVM09AB; Digi-Key_PN 568-14726-ND
U23: MPU-6050_NRND; QFN-24-1EP_4x4mm; Mfg PN MPU-6050; Digi-Key_PN 1428-1007-1-ND
U24: MS860702BA01-50; TE_MS860702BA01-50; Mfg PN MS860702BA01-50; Digi-Key_PN 223-1701-1-ND
U25: VEML6030-GS15; VISHAY_VEML6030_2X2X0.87; Mfg PN VEML6030-GS15; Digi-Key_PN VEML6030-GS15CT-ND
U26: MMC5883MA; PQFN50P300X300X100-16N; Mfg PN MMC5883MA; Digi-Key_PN 1267-1072-1-ND

Connections:
A71CH_RESET: U2.A16 (ENET2_TX_DATA1)
Amb_sensor_INT: R63.1, U2.M17 (GPIO1_IO05), U25.3
DCDC_3V3: C111.1, C114.1, C115.1, C116.1, C119.1, C120.1, C123.1, C125.1, LED1.2 (A), LED2.2 (A), LED3.2 (A), LED4.2 (A), LED5.2 (A), R25.2, R61.2, R62.2, R63.2, R64.1, R65.1, U2.C4 (NVCC_SD1), U2.F4 (NVCC_CSI), U2.F13 (NVCC_ENET), U2.J13 (NVCC_GPIO), U23.8 (VLOGIC), U23.13 (VDD), U24.1 (VDD), U26.2 (VDD), U26.13 (VDDIO)
GND: C111.2, C112.2, C113.2, C114.2, C115.2, C116.2, C117.2, C118.2, C119.2, C120.2, C121.2, C122.2, C123.2, C124.2, C125.2, R66.2, U23.1 (CLKIN), U23.9 (AD0), U23.11 (FSYNC), U23.18 (GND), U24.3 (GND), U25.1, U26.9 (GND), U26.11 (GND)
GPS_PIO14: U2.D16 (ENET2_RX_ER)
GPS_RESET: U2.C16 (ENET2_RX_DATA1)
GPS_SAFEBOOT_N: U2.D17 (ENET2_TX_CLK)
I2C1_SCL: R64.2, U2.L14 (GPIO1_IO02)
I2C1_SDA: R65.2, U2.L17 (GPIO1_IO03)
I2C2_SCL: U23.23 (SCL/SCLK), U24.8 (SCL), U25.5, U26.1 (SCL)
I2C2_SDA: U23.24 (SDA), U24.7 (SDA), U25.2, U26.16 (SDA)
ICS43434_SCK: U2.E1 (CSI_DATA03)
ICS43434_SD: U2.D2 (CSI_DATA06)
ICS43434_WS: U2.E2 (CSI_DATA02)
LDO2_3V3: C112.1, C113.1, D6.2 (A), D7.2 (A), U2.L13 (VDDA_ADC_3P3), U2.M13 (ADC_VREFH)
MPU6K_INT: R61.1, U2.L15 (GPIO1_IO01), U23.12 (INT)
unnamed: C117.1, U23.20 (CPOUT)
unnamed: C118.1, U23.10 (REGOUT)
unnamed: C121.1, C122.1, R62.1, U25.4, U25.6
unnamed: C124.1, U26.10 (CAP)
unnamed: D6.1 (K), R59.1
unnamed: D7.1 (K), R60.1
unnamed: LED1.1 (K), R67.1
unnamed: LED2.1 (K), R68.1
unnamed: LED3.1 (K), R69.1
unnamed: LED4.1 (K), R70.1
unnamed: LED5.1 (K), R71.1
unnamed: R59.2, U2.E4 (CSI_DATA00)
unnamed: R60.2, U2.E3 (CSI_DATA01)
PMIC_WDI: U2.F15 (ENET1_TX_EN)
SE1_LED: R67.2, U2.M15 (GPIO1_IO09)
SE2_LED: R68.2, U2.N17 (GPIO1_IO08)
SE3_LED: R69.2, U2.L16 (GPIO1_IO07)
SE4_LED: R70.2, U2.K17 (GPIO1_IO06)
SE5_LED: R71.2, U2.M16 (GPIO1_IO04)
SLS32A_RESET: U2.C17 (ENET2_RX_DATA0)
USB1_INT_B: R25.1, U2.K13 (GPIO1_IO00)
eCompass_INT: R66.1, U2.B17 (ENET2_RX_EN), U26.15 (INT)

Notes on the sheet:
ADC_VREFH: tied to VDDA_ADC_3P3 [1] pg 18
VDDA_ADC_3P3 must be powered even if the ADC is not used. [1] pg 18
I2C1_SCL [ALT0]
I2C1_SDA [ALT0]
GPIO1_IO9 [ALT5]
GPIO1_IO6 [ALT5]
GPIO1_IO4 [ALT5]
I2C1 ADDRESSES (8bit address / 7 bit address) 0x10 / 0x08: PMIC (400 kHz) 0xC0 / 0x60: ATECC608A Microchip SECURE ELEMENT (1 MHz) 0x92 / 0x49: A71CH NXP SECURE ELEMENT (400 kHz) 0xC2 / 0x61: TUSB320 USB1 (Type-C plug) (400 kHz) 0x30 / 0x : SLS32AIA010MH OPTIGA SECURE ELEMENT (400kHz) 0x50 / 0x : A1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
GPIO1_IO0 [ALT5]
ENET1_TX_EN (ULZ: KPP_COL2) -> WDOG2_WDOG_RST_B_DEB [ALT8]
CSI_DATA00 (ULZ: SD2_DATA0) -> GPIO4_IO21 [ALT5]
CSI_DATA01 (ULZ: SD2_DATA1) -> GPIO4_IO22 [ALT5]
ULZ: VDD_HIGH_IN
Secure Elements LEDS
Pressure, Humidity & Temp Sensors
I2C Adress: Pressure & Tempreature: 0x76 Relative Humidity: 0x40
High Accuracy Ambient Light Sensor
I2C Adress: 0x48
GPIO1_IO5 [ALT5]-Ambient Sensor Interrupt
GPIO1_IO7 [ALT5]
GPIO1_IO8 [ALT5]
I2C Adress: 0x68
GPIO1_IO1 [ALT5]
Accelerometer, Gyroscope, 6 Axis Sensor
RX_SYNC -> CSI_DATA02 -> GPIO4_IO23
RX_BCLK -> CSI_DATA03 -> GPIO4_IO24
RX_DATA -> CSI_DATA06 -> GPIO4_IO27
GPIO2_IO8
GPIO2_IO9
GPIO2_IO15
e-Compass
I2C Adress: 0x30
GPIO2_IO14
I2C2 ADDRESSES (8bit address / 7 bit address) 0x76 / 0xXX: Pressure & Tempreature (400KHz) 0x40 / 0xXX: Relative Humidity (400KHz) 0x48 / 0xXX: Ambient Light Sensor (400KHz) 0x68 / 0xXX: Acc Gyro 6 Axis Sensor (400KHz) 0x30 / 0xXX: eCompass (400KHz) 0x42 / 0x21: GPS ZOE-M8Q-0-10 (400 kHz) 0x52 / 0x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
GPIO2_IO10
