FranciscoVentures/EN7767/Hardware/pmic.sch

## KiCad design Hardware/pmic.sch (2021-01-12)

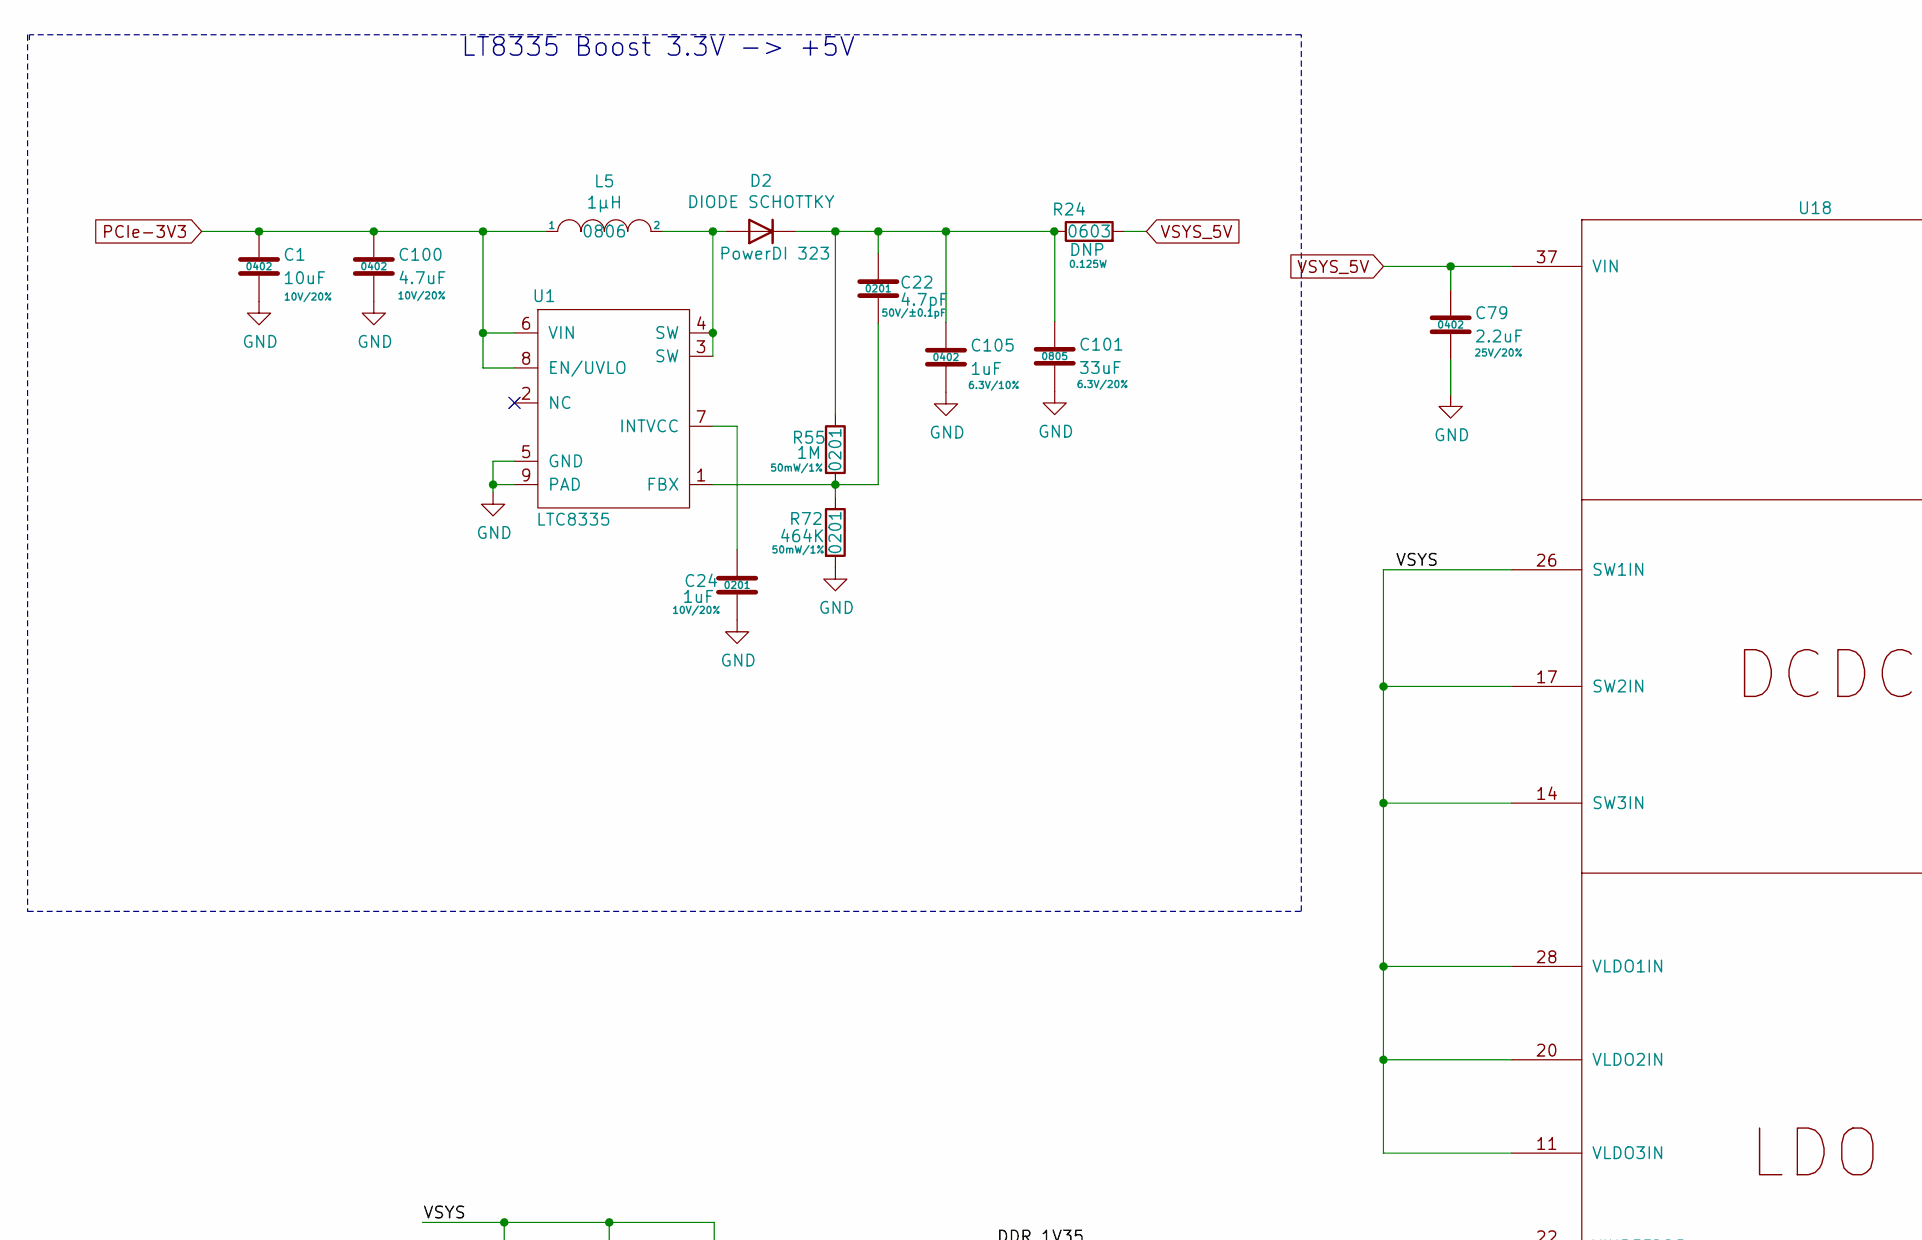
[picture p7: schematic pmic.sch, part in row 1, column 1]

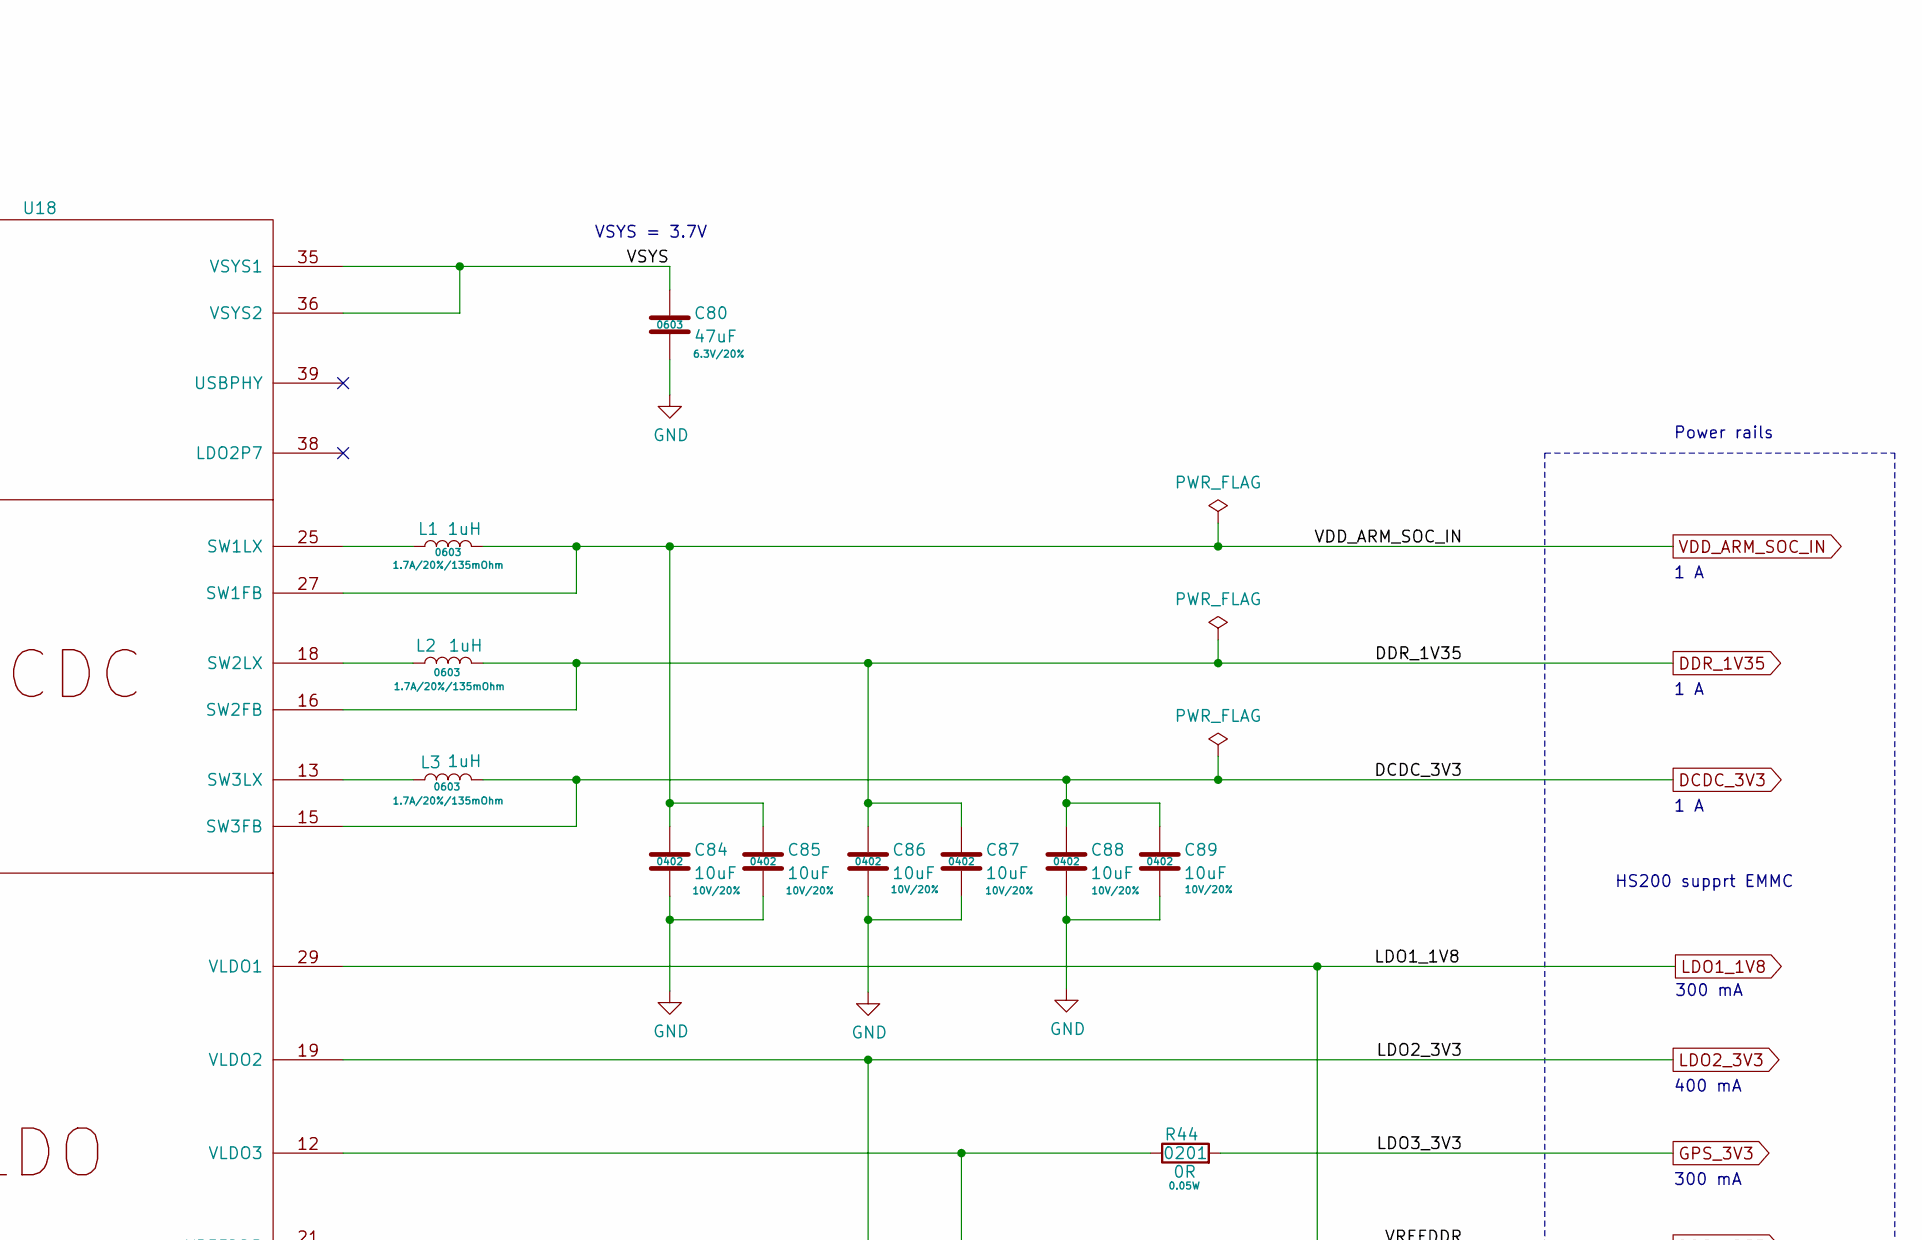
[picture p8: schematic pmic.sch, part in row 1, column 2]

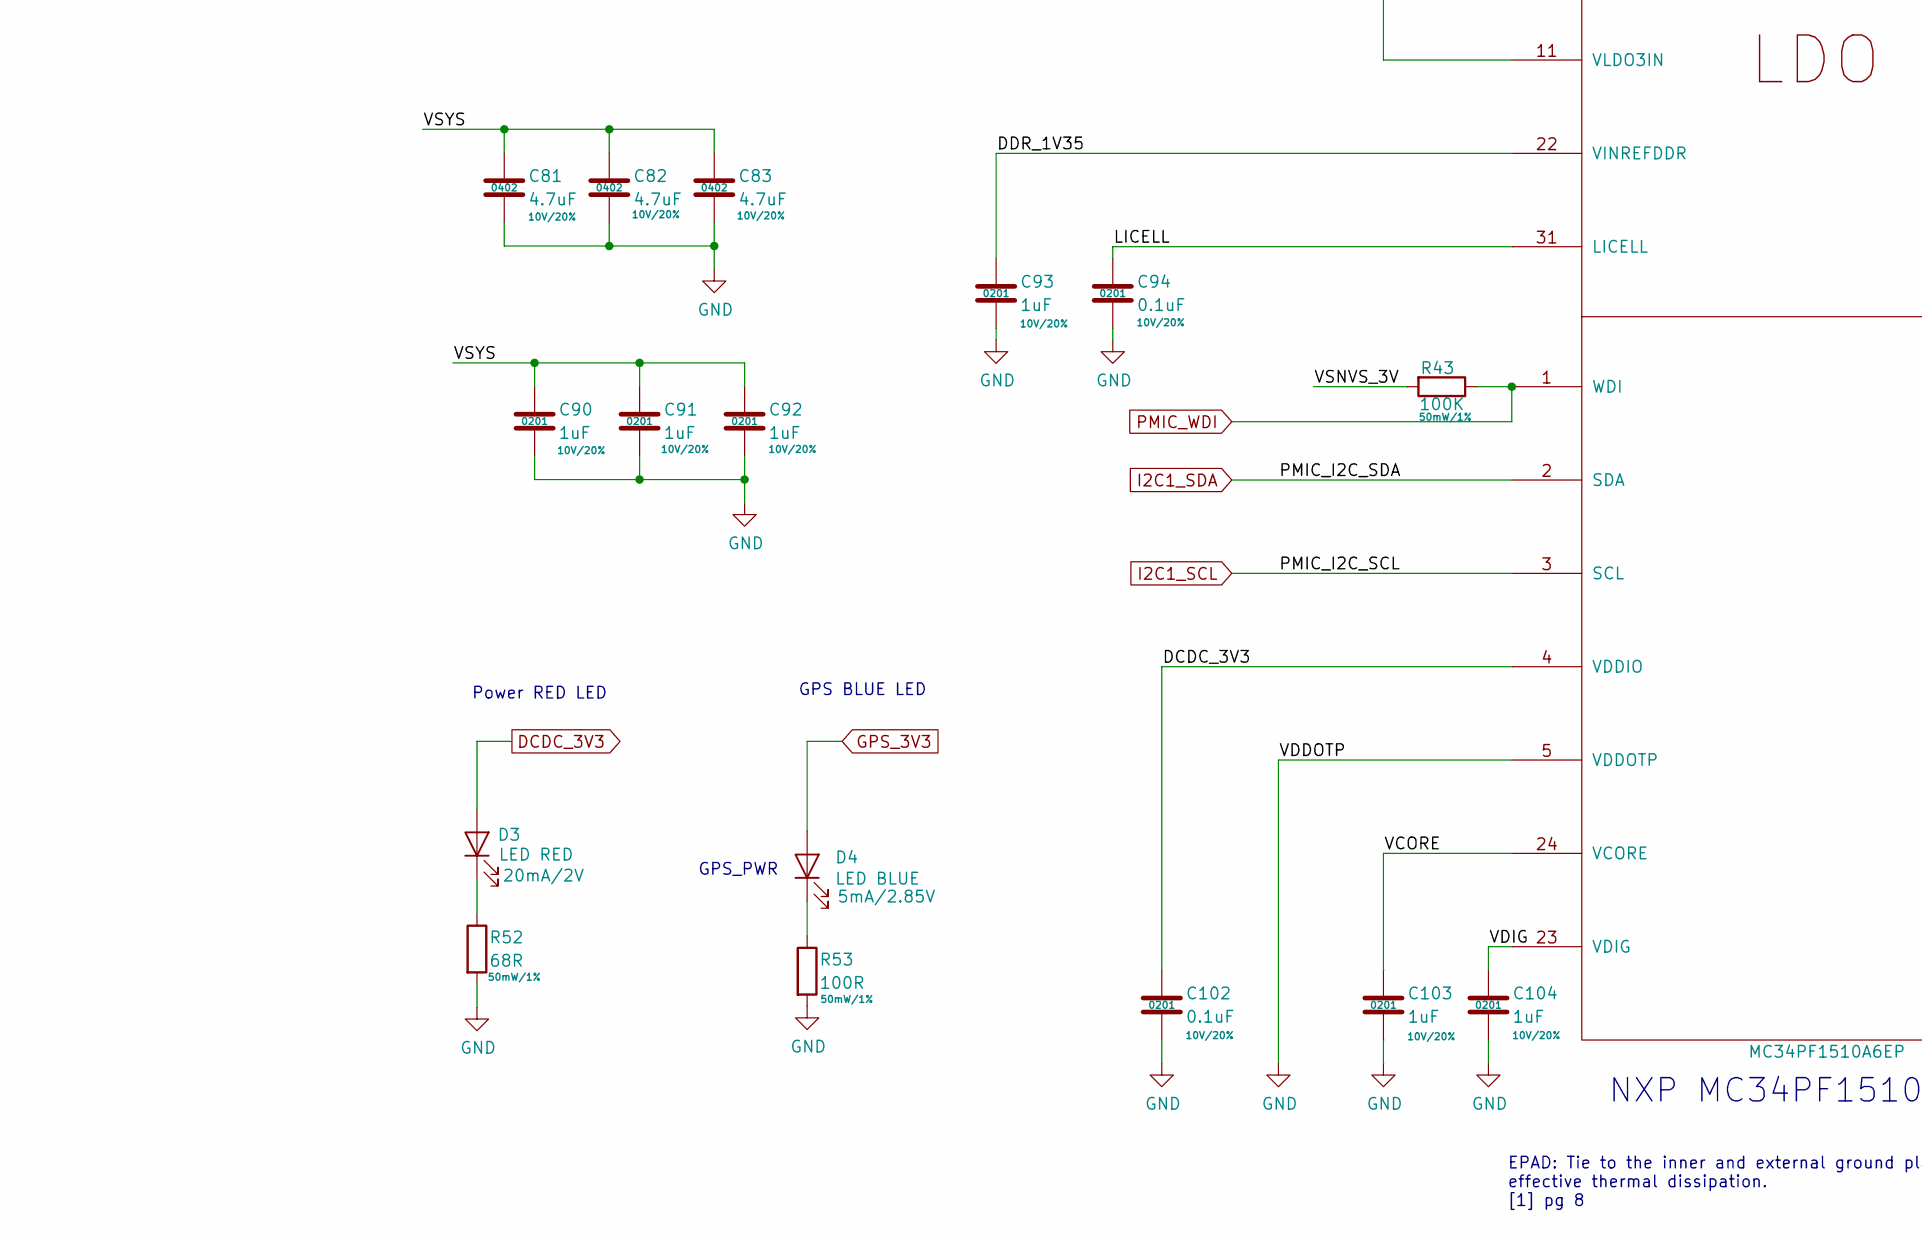
[picture p9: schematic pmic.sch, part in row 2, column 1]

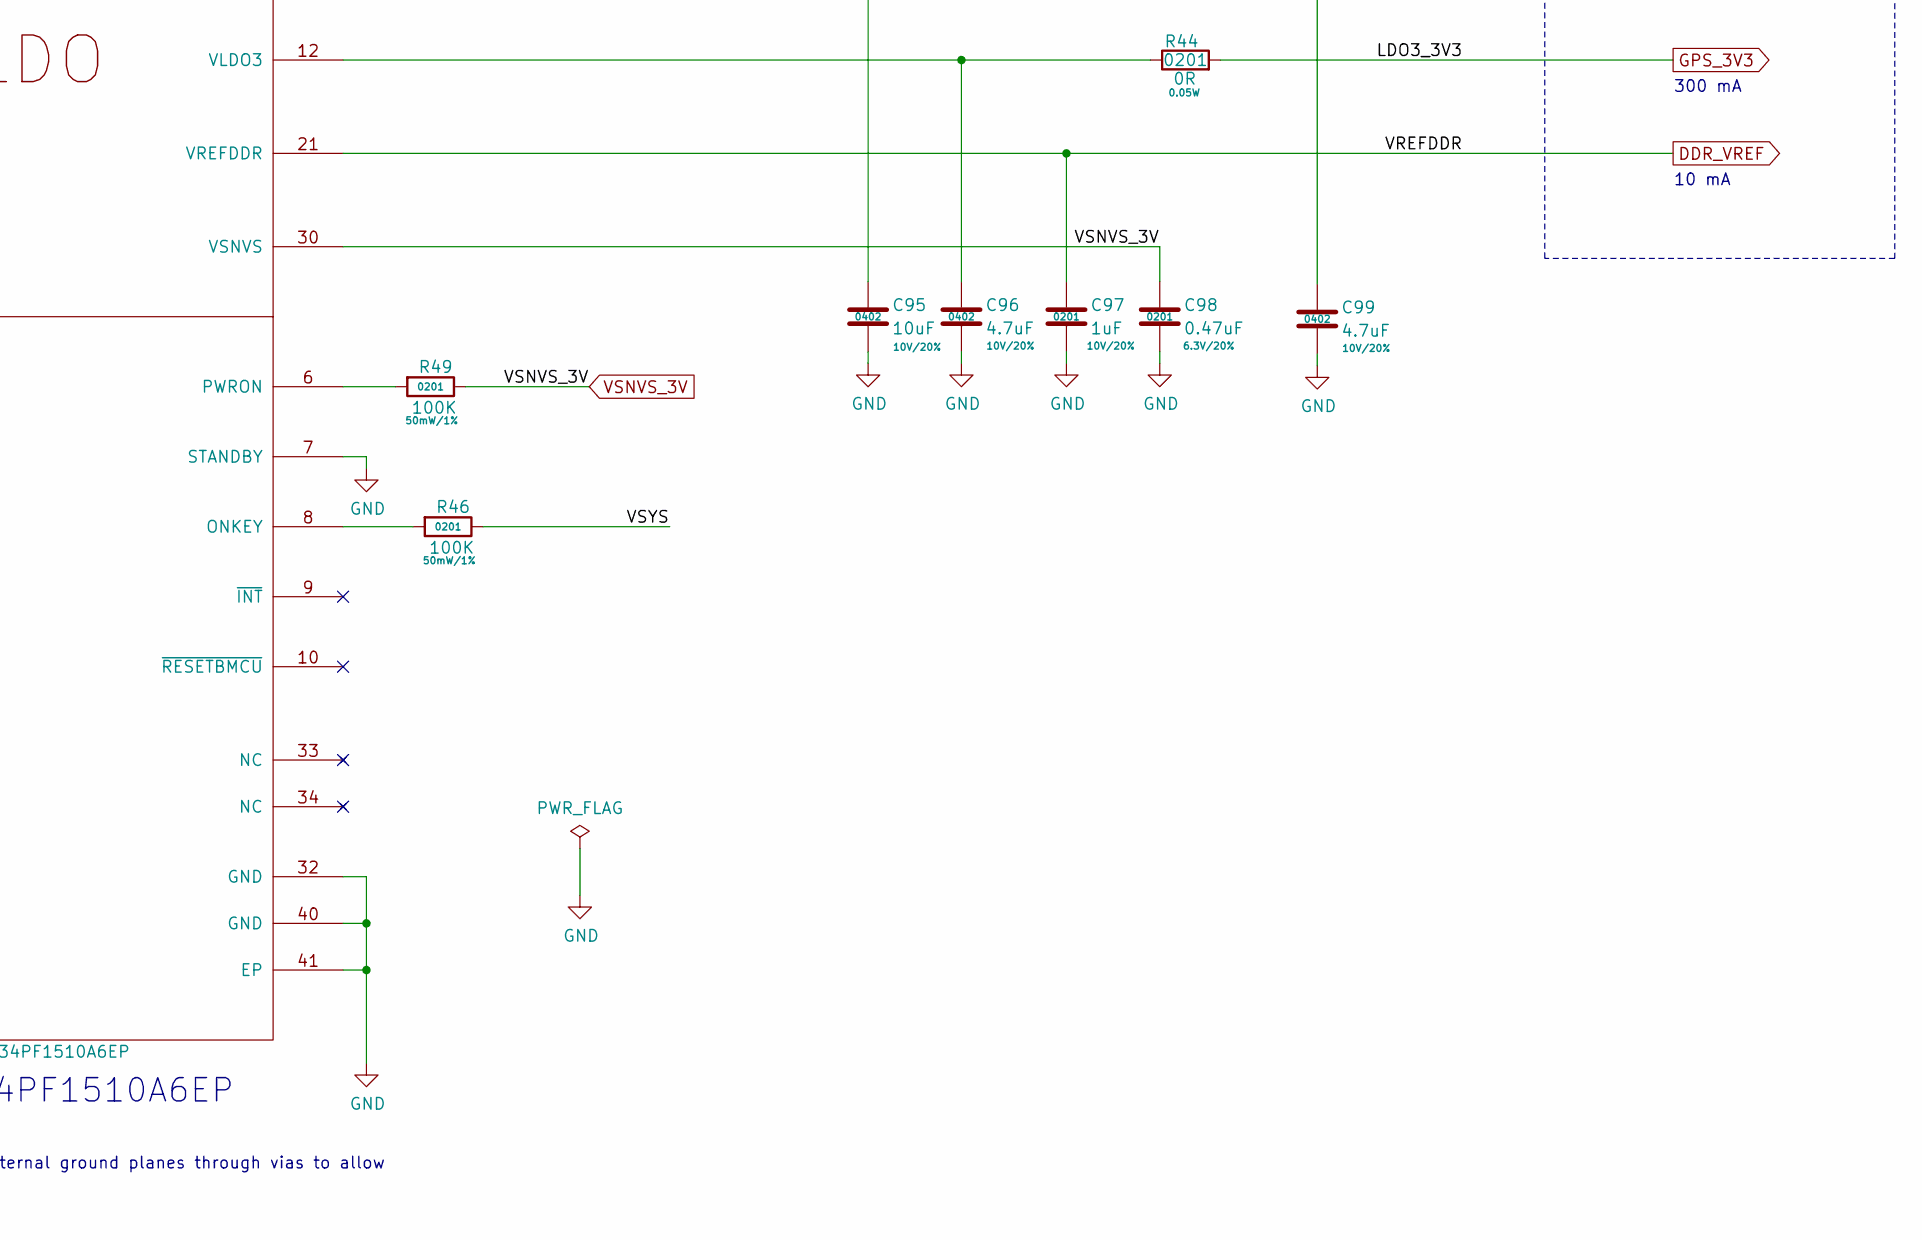
[picture p10: schematic pmic.sch, part in row 2, column 2]

Parts:
C1, C84, C85, C86, C87, C88, C89, C95: 10uF; SM0402; Rating 10V/20%; Mfg PN CL05A106MP8NUB8; Digi-Key_PN 1276-6830-1-ND
C22: 4.7pF; SM0201; Rating 50V/±0.1pF; Mfg PN GRM0335C1H4R7BA01D; Digi-Key_PN 490-11332-1-ND
C24, C90, C91, C92, C93, C97, C103, C104: 1uF; SM0201; Rating 10V/20%; Mfg PN CL03A105MP3ZSNH; Digi-Key_PN 1276-6816-1-ND
C79: 2.2uF; SM0402; Rating 25V/20%; Mfg PN GRM155R61E225ME15D; Digi-Key_PN 490-10457-1-ND
C80: 47uF; SM0603; Rating 6.3V/20%; Mfg PN GRM188R60J476ME15D; Digi-Key_PN 490-13247-1-ND
C81, C82, C83, C96, C99, C100: 4.7uF; SM0402; Rating 10V/20%; Mfg PN ZRB15XR61A475ME01D; Digi-Key_PN 490-10984-1-ND
C94, C102: 0.1uF; SM0201; Rating 10V/20%; Mfg PN GRM033R61A104ME15D; Digi-Key_PN 490-5405-1-ND
C98: 0.47uF; SM0201; Rating 6.3V/20%; Mfg PN GRM033R60J474ME90D; Digi-Key_PN 490-10410-1-ND
C101: 33uF; C_0805_2012Metric; Rating 6.3V/20%; Mfg PN GRM155R61E225ME15D; Digi-Key_PN 445-5986-1-ND
C105: 1uF; SM0402; Rating 6.3V/10%; Mfg PN GRM155R70J105KA12J; Digi-Key_PN 490-13339-2-ND
D2: DIODE SCHOTTKY; D_PowerDI-123; Mfg PN PD3S160-7; Digi-Key_PN PD3S160DITR-ND
D3: LED RED; LED_0603; Rating 20mA/2V; Mfg PN LS Q976-NR-1; Digi-Key_PN 475-2512-1-ND
D4: LED BLUE; LED_0603; Rating 5mA/2.85V; Mfg PN LB Q39G-L2OO-35-1; Digi-Key_PN 475-2816-1-ND
L1, L2, L3: 1uH; SM0603; Rating 1.7A/20%/135mOhm; Mfg PN LPWI160808H1R0T; Digi-Key_PN F12082CT-ND
L5: 1µH; L_1806_4516Metric_Pad1.57x1.80mm_HandSolder; Mfg PN TFM201610ALMA1R0MTAA; Digi-Key_PN 445-174574-1-ND
R24: DNP; R_0603_1608Metric; Rating 0.125W; Mfg PN CRCW08050000Z0EB; Digi-Key_PN 541-CRCW08050000Z0EBCT-ND
R43, R46, R49: 100K; R_0201_0603Metric; Rating 50mW/1%; Mfg PN CRCW0201100KJNED; Digi-Key_PN 541-100KAGCT-ND
R44: 0R; R_0201_0603Metric; Rating 0.05W; Mfg PN CRCW02010000Z0ED; Digi-Key_PN 541-0.0AGCT-ND
R52: 68R; R_0201_0603Metric; Rating 50mW/1%; Mfg PN CRCW020168R0FNED; Digi-Key_PN 541-CRCW020168R0FNEDCT-ND
R53: 100R; R_0201_0603Metric; Rating 50mW/1%; Mfg PN CRCW0201100RFNED; Digi-Key_PN 541-100ABCT-ND
R55: 1M; R_0201_0603Metric; Rating 50mW/1%; Mfg PN CRCW02011M00FNED; Digi-Key_PN 541-1.00MABCT-ND
R72: 464K; R_0201_0603Metric; Rating 50mW/1%; Mfg PN CRCW0201464KFNED; Digi-Key_PN 541-CRCW0201464KFNEDCT-ND
U1: LTC8335; DFN-8_DDB; Mfg PN LT8335EDDB#TRMPBF; Digi-Key_PN LT8335EDDB#TRMPBFCT-ND
U18: MC34PF1510A6EP; SOT1369-4; Mfg PN MC34PF1510A6EP; Digi-Key_PN 568-14653-1-ND

Connections:
DCDC_3V3: C88.1, C89.1, C102.1, D3.2 (A), L3.2, U18.4 (VDDIO), U18.15 (SW3FB)
DDR_1V35: C86.1, C87.1, C93.1, L2.2, U18.16 (SW2FB), U18.22 (VINREFDDR)
DDR_VREF: C97.1, U18.21 (VREFDDR)
GND: C1.2, C24.2, C79.2, C80.2, C81.2, C82.2, C83.2, C84.2, C85.2, C86.2, C87.2, C88.2, C89.2, C90.2, C91.2, C92.2, C93.2, C94.2, C95.2, C96.2, C97.2, C98.2, C99.2, C100.2, C101.2, C102.2, C103.2, C104.2, C105.2, R52.2, R53.2, R72.2, U1.5 (GND), U1.9 (PAD), U18.5 (VDDOTP), U18.7 (STANDBY), U18.32 (GND), U18.40 (GND), U18.41 (EP)
GPS_3V3: D4.2 (A), R44.2
I2C1_SCL: U18.3 (SCL)
I2C1_SDA: U18.2 (SDA)
LDO1_1V8: C99.1, U18.29 (VLDO1)
LDO2_3V3: C95.1, U18.19 (VLDO2)
LICELL: C94.1, U18.31 (LICELL)
unnamed: C22.2, R55.2, R72.1, U1.1 (FBX)
unnamed: C24.1, U1.7 (INTVCC)
unnamed: C96.1, R44.1, U18.12 (VLDO3)
unnamed: C22.1, C101.1, C105.1, D2.1 (K), R24.1, R55.1
unnamed: D2.2 (A), L5.2, U1.3 (SW), U1.4 (SW)
unnamed: D3.1 (K), R52.1
unnamed: D4.1 (K), R53.1
unnamed: L1.1, U18.25 (SW1LX)
unnamed: L2.1, U18.18 (SW2LX)
unnamed: L3.1, U18.13 (SW3LX)
unnamed: R46.2, U18.8 (ONKEY)
unnamed: R49.2, U18.6 (PWRON)
PCIe-3V3: C1.1, C100.1, L5.1, U1.6 (VIN), U1.8 (EN/UVLO)
PMIC_WDI: R43.1, U18.1 (WDI)
VCORE: C103.1, U18.24 (VCORE)
VDD_ARM_SOC_IN: C84.1, C85.1, L1.2, U18.27 (SW1FB)
VDIG: C104.1, U18.23 (VDIG)
VSNVS_3V: C98.1, R43.2, R49.1, U18.30 (VSNVS)
VSYS: C80.1, C81.1, C82.1, C83.1, C90.1, C91.1, C92.1, R46.1, U18.11 (VLDO3IN), U18.14 (SW3IN), U18.17 (SW2IN), U18.20 (VLDO2IN), U18.26 (SW1IN), U18.28 (VLDO1IN), U18.35 (VSYS1), U18.36 (VSYS2)
VSYS_5V: C79.1, R24.2, U18.37 (VIN)

Notes on the sheet:
EPAD: Tie to the inner and external ground planes through vias to allow effective thermal dissipation. [1] pg 8
400 mA
300 mA
1 A
10 mA
Power rails
NXP MC34PF1510A6EP
Power RED LED
GPS_PWR
GPS BLUE LED
HS200 supprt EMMC
VSYS = 3.7V
LT8335 Boost 3.3V -> +5V
