FranciscoVentures/EN7767/Hardware/power-tree.sch

## KiCad design Hardware/power-tree.sch (2021-01-12)

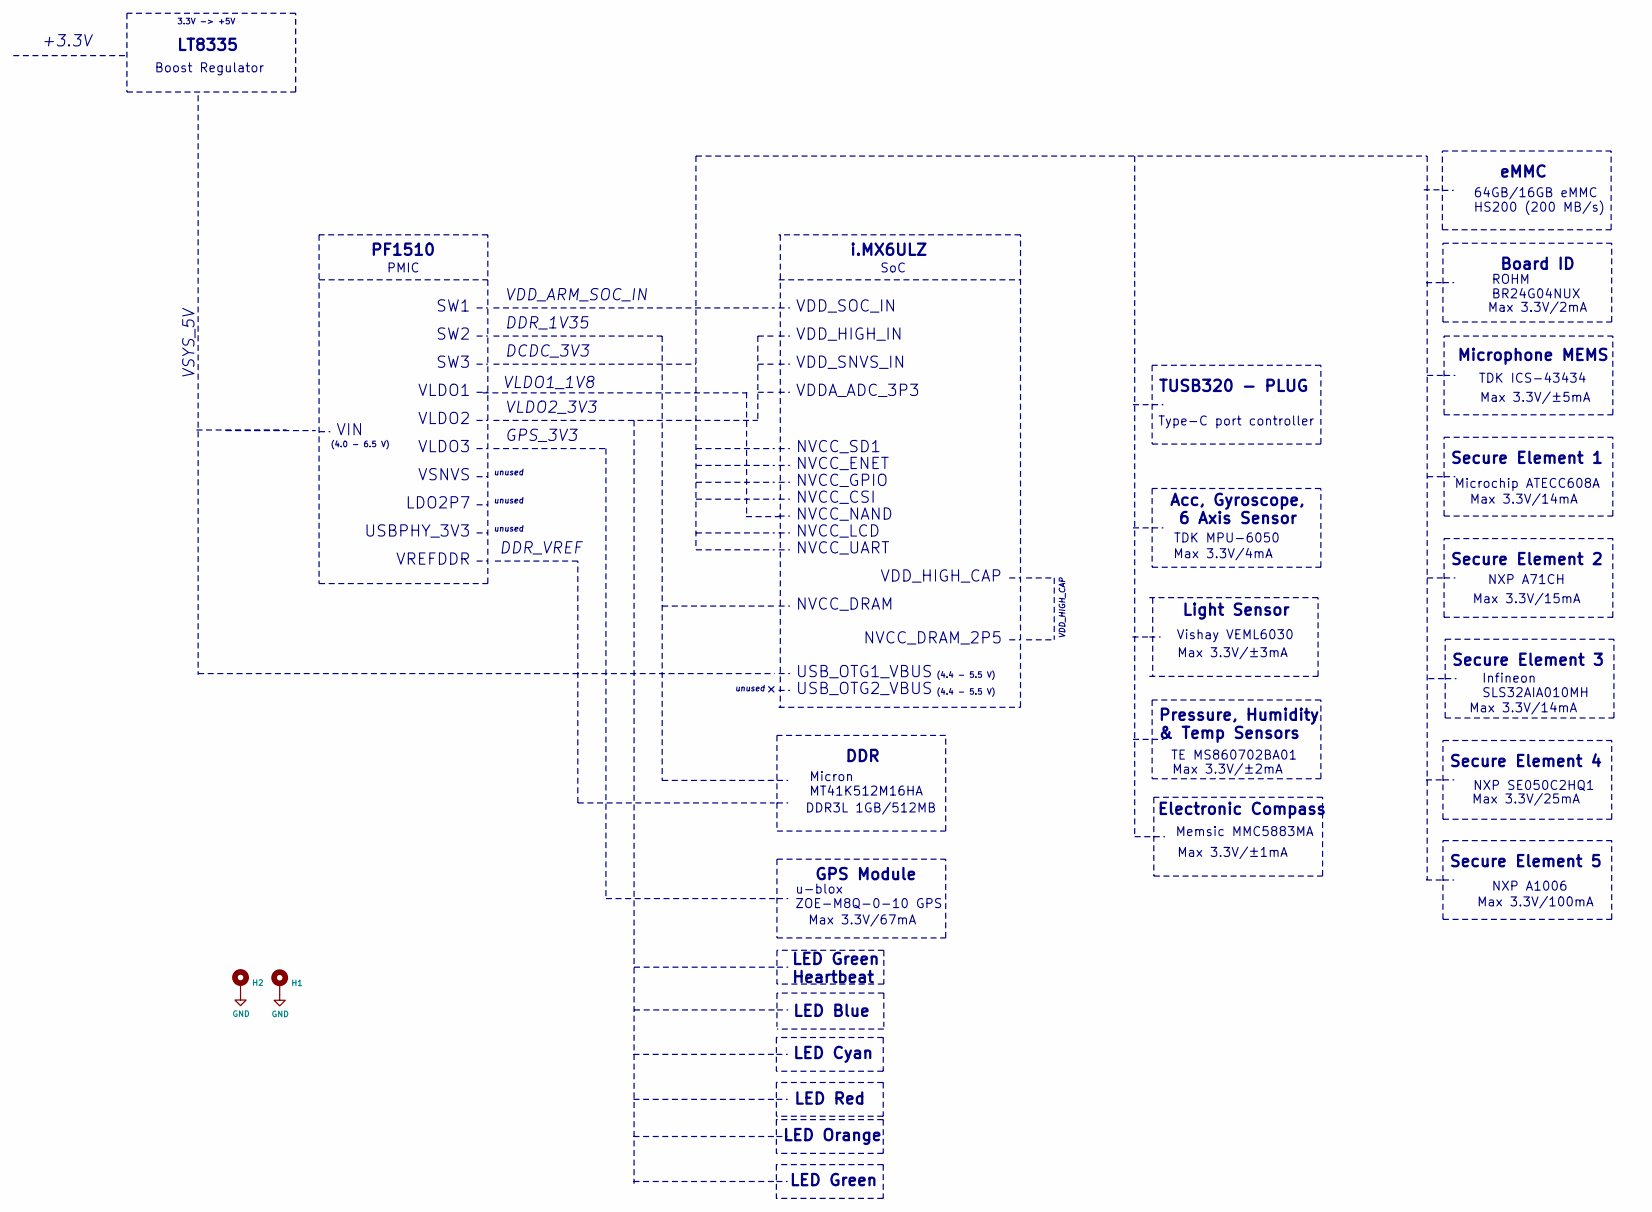
[picture p11: schematic power-tree.sch]

Parts:
H1, H2: MountingHole_Pad; MINI_PCIE_MOUNTING_HOLE

Connections:
GND: H1.1, H2.1

Notes on the sheet:
i.MX6ULZ
NVCC_ENET
VDD_SOC_IN
VDD_HIGH_IN
VDD_SNVS_IN
USB_OTG1_VBUS
VDDA_ADC_3P3
NVCC_GPIO
NVCC_CSI
NVCC_NAND
NVCC_SD1
NVCC_LCD
NVCC_UART
USB_OTG2_VBUS
NVCC_DRAM
NVCC_DRAM_2P5
VIN
Type-C port controller
TUSB320 - PLUG
GPS Module
u-blox ZOE-M8Q-0-10 GPS
TDK ICS-43434
Microphone MEMS
DDR3L 1GB/512MB
DDR
Microchip ATECC608A
Secure Element 1
VSYS_5V
PMIC
PF1510
USBPHY_3V3
SW3
SW2
VLDO2
VLDO3
VSNVS
VLDO1
SW1
LDO2P7
VREFDDR
SoC
VDD_ARM_SOC_IN
DCDC_3V3
DDR_1V35
VLDO2_3V3
unused
NXP A71CH
Secure Element 2
VDD_HIGH_CAP
GPS_3V3
LED Green Heartbeat
LED Blue
(4.4 - 5.5 V)
DDR_VREF
(4.0 - 6.5 V)
Infineon SLS32AIA010MH
Secure Element 3
NXP SE050C2HQ1
Secure Element 4
NXP A1006
Secure Element 5
ROHM BR24G04NUX
Board ID
64GB/16GB eMMC HS200 (200 MB/s)
eMMC
TDK MPU-6050
Acc, Gyroscope, 6 Axis Sensor
Vishay VEML6030
Light Sensor
TE MS860702BA01
Pressure, Humidity & Temp Sensors
Memsic MMC5883MA
Electronic Compass
Max 3.3V/100mA
Max 3.3V/25mA
Max 3.3V/14mA
Max 3.3V/15mA
Max 3.3V/±5mA
Max 3.3V/2mA
Max 3.3V/4mA
Max 3.3V/±3mA
Max 3.3V/±2mA
Max 3.3V/±1mA
Max 3.3V/67mA
Micron MT41K512M16HA
VLDO1_1V8
LED Cyan
LED Red
LED Orange
LED Green
+3.3V
Boost Regulator
LT8335
3.3V -> +5V
