FranciscoVentures/EN7767/Hardware/power.sch

## KiCad design Hardware/power.sch (2021-01-12)

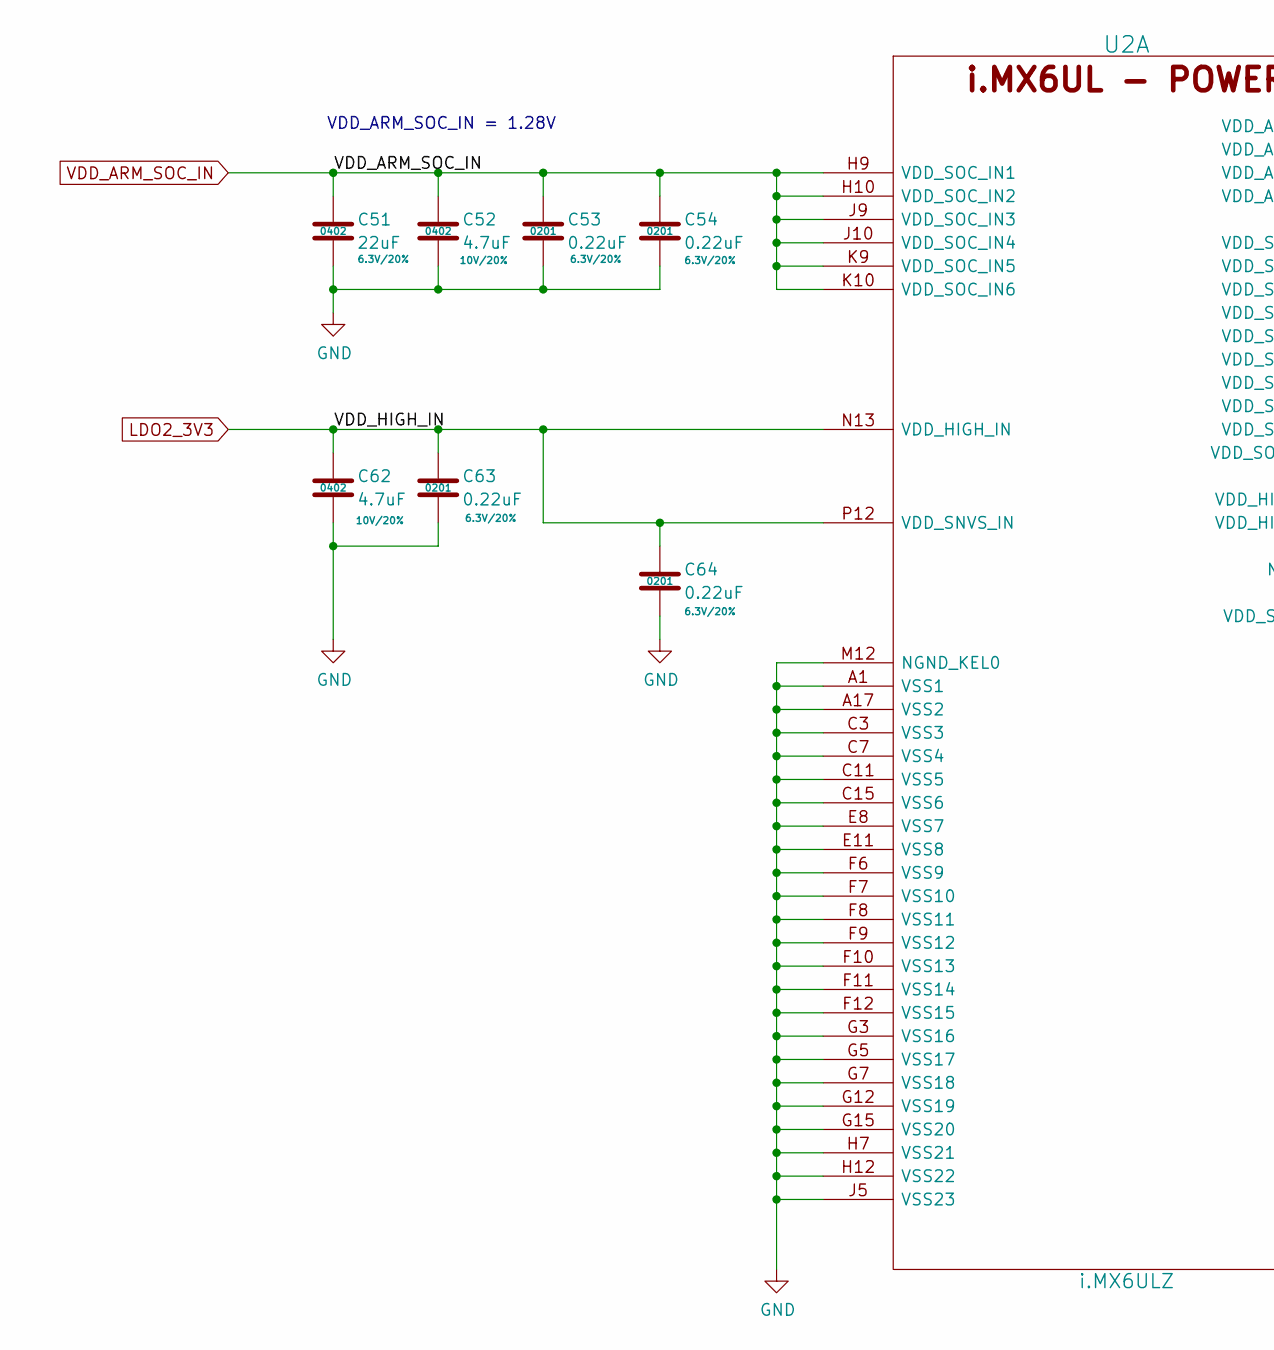
[picture p12: schematic power.sch, part in row 1, column 1]

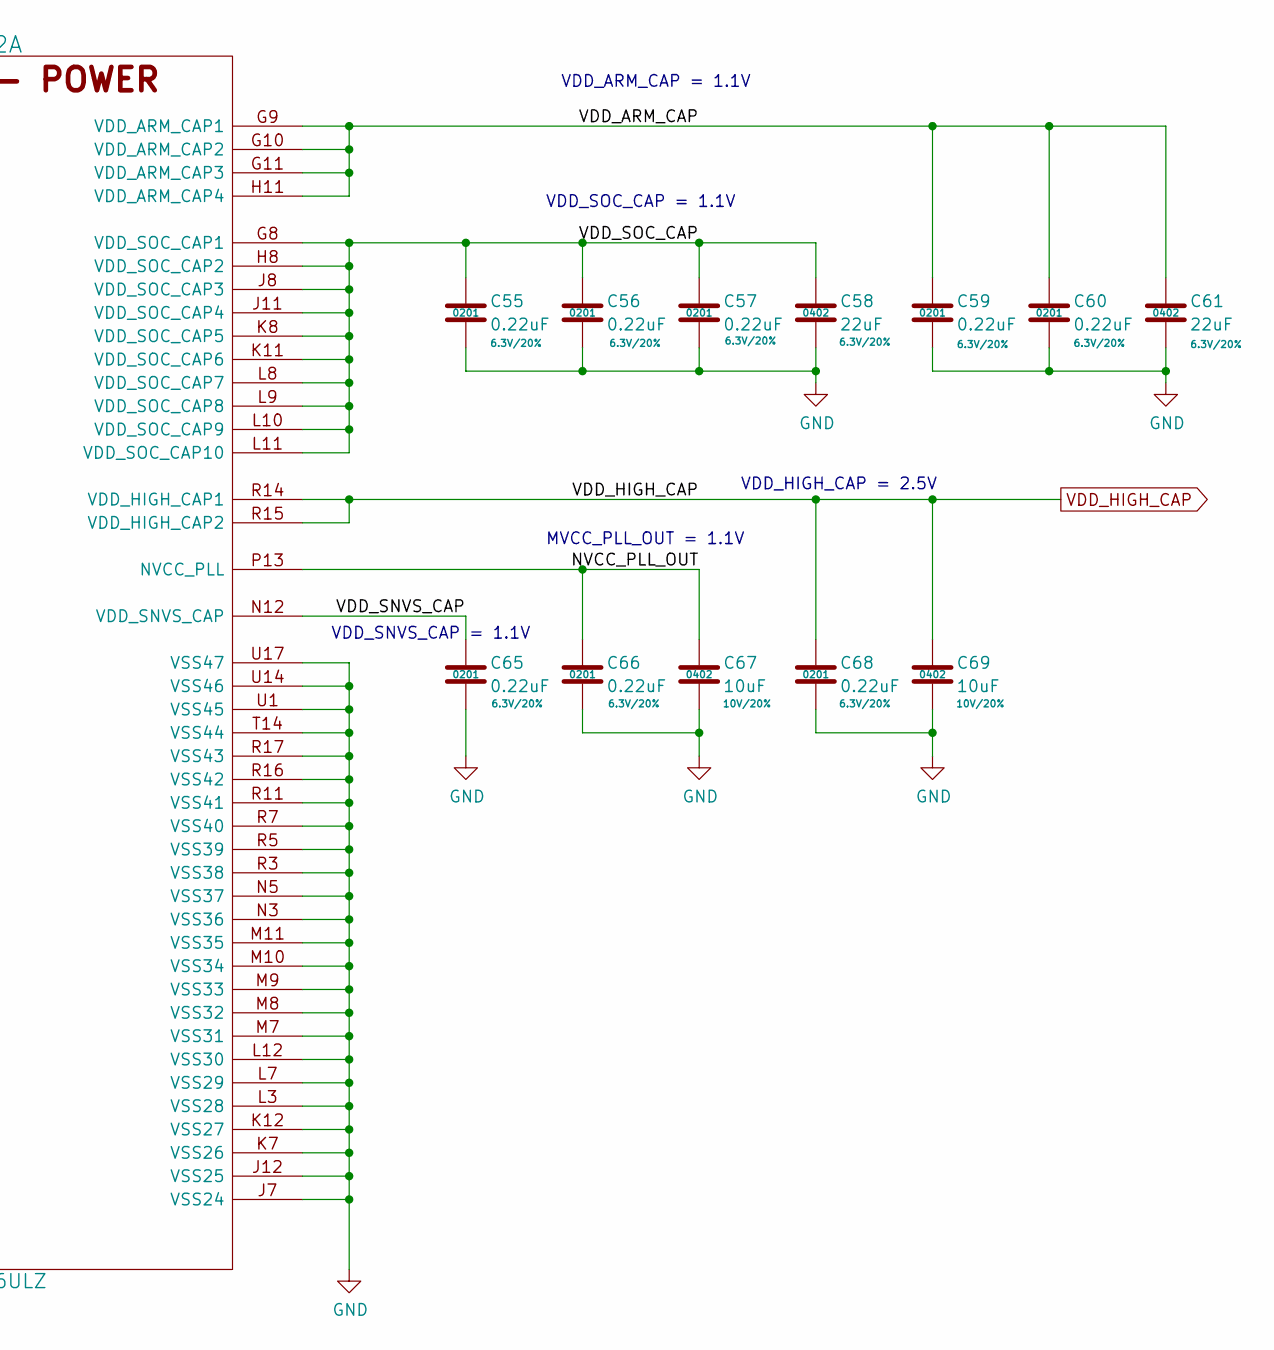
[picture p13: schematic power.sch, part in row 1, column 2]

Parts:
C51, C58, C61: 22uF; SM0402; Rating 6.3V/20%; Mfg PN CL05A226MQ5N6J8; Digi-Key_PN 1276-7090-1-ND
C52, C62: 4.7uF; SM0402; Rating 10V/20%; Mfg PN ZRB15XR61A475ME01D; Digi-Key_PN 490-10984-1-ND
C53, C54, C55, C56, C57, C59, C60, C63, C64, C65, C66, C68: 0.22uF; SM0201; Rating 6.3V/20%; Mfg PN GRM033R60J224ME15D; Digi-Key_PN 490-10407-1-ND
C67, C69: 10uF; SM0402; Rating 10V/20%; Mfg PN CL05A106MP8NUB8; Digi-Key_PN 1276-6830-1-ND
U2: i.MX6ULZ; SOT1534-2; Mfg PN MCIMX6Z0DVM09AB; Digi-Key_PN 568-14726-ND

Connections:
GND: C51.2, C52.2, C53.2, C54.2, C55.2, C56.2, C57.2, C58.2, C59.2, C60.2, C61.2, C62.2, C63.2, C64.2, C65.2, C66.2, C67.2, C68.2, C69.2, U2.A1 (VSS1), U2.A17 (VSS2), U2.C3 (VSS3), U2.C7 (VSS4), U2.C11 (VSS5), U2.C15 (VSS6), U2.E8 (VSS7), U2.E11 (VSS8), U2.F6 (VSS9), U2.F7 (VSS10), U2.F8 (VSS11), U2.F9 (VSS12), U2.F10 (VSS13), U2.F11 (VSS14), U2.F12 (VSS15), U2.G3 (VSS16), U2.G5 (VSS17), U2.G7 (VSS18), U2.G12 (VSS19), U2.G15 (VSS20), U2.H7 (VSS21), U2.H12 (VSS22), U2.J5 (VSS23), U2.J7 (VSS24), U2.J12 (VSS25), U2.K7 (VSS26), U2.K12 (VSS27), U2.L3 (VSS28), U2.L7 (VSS29), U2.L12 (VSS30), U2.M7 (VSS31), U2.M8 (VSS32), U2.M9 (VSS33), U2.M10 (VSS34), U2.M11 (VSS35), U2.M12 (NGND_KEL0), U2.N3 (VSS36), U2.N5 (VSS37), U2.R3 (VSS38), U2.R5 (VSS39), U2.R7 (VSS40), U2.R11 (VSS41), U2.R16 (VSS42), U2.R17 (VSS43), U2.T14 (VSS44), U2.U1 (VSS45), U2.U14 (VSS46), U2.U17 (VSS47)
LDO2_3V3: C62.1, C63.1, C64.1, U2.N13 (VDD_HIGH_IN), U2.P12 (VDD_SNVS_IN)
NVCC_PLL_OUT: C66.1, C67.1, U2.P13 (NVCC_PLL)
VDD_ARM_CAP: C59.1, C60.1, C61.1, U2.G9 (VDD_ARM_CAP1), U2.G10 (VDD_ARM_CAP2), U2.G11 (VDD_ARM_CAP3), U2.H11 (VDD_ARM_CAP4)
VDD_ARM_SOC_IN: C51.1, C52.1, C53.1, C54.1, U2.H9 (VDD_SOC_IN1), U2.H10 (VDD_SOC_IN2), U2.J9 (VDD_SOC_IN3), U2.J10 (VDD_SOC_IN4), U2.K9 (VDD_SOC_IN5), U2.K10 (VDD_SOC_IN6)
VDD_HIGH_CAP: C68.1, C69.1, U2.R14 (VDD_HIGH_CAP1), U2.R15 (VDD_HIGH_CAP2)
VDD_SNVS_CAP: C65.1, U2.N12 (VDD_SNVS_CAP)
VDD_SOC_CAP: C55.1, C56.1, C57.1, C58.1, U2.G8 (VDD_SOC_CAP1), U2.H8 (VDD_SOC_CAP2), U2.J8 (VDD_SOC_CAP3), U2.J11 (VDD_SOC_CAP4), U2.K8 (VDD_SOC_CAP5), U2.K11 (VDD_SOC_CAP6), U2.L8 (VDD_SOC_CAP7), U2.L9 (VDD_SOC_CAP8), U2.L10 (VDD_SOC_CAP9), U2.L11 (VDD_SOC_CAP10)

Notes on the sheet:
VDD_ARM_SOC_IN = 1.28V
VDD_ARM_CAP = 1.1V
VDD_SOC_CAP = 1.1V
VDD_HIGH_CAP = 2.5V
MVCC_PLL_OUT = 1.1V
VDD_SNVS_CAP = 1.1V
