FranciscoVentures/EN7767/Hardware/secure-element.sch

## KiCad design Hardware/secure-element.sch (2021-01-12)

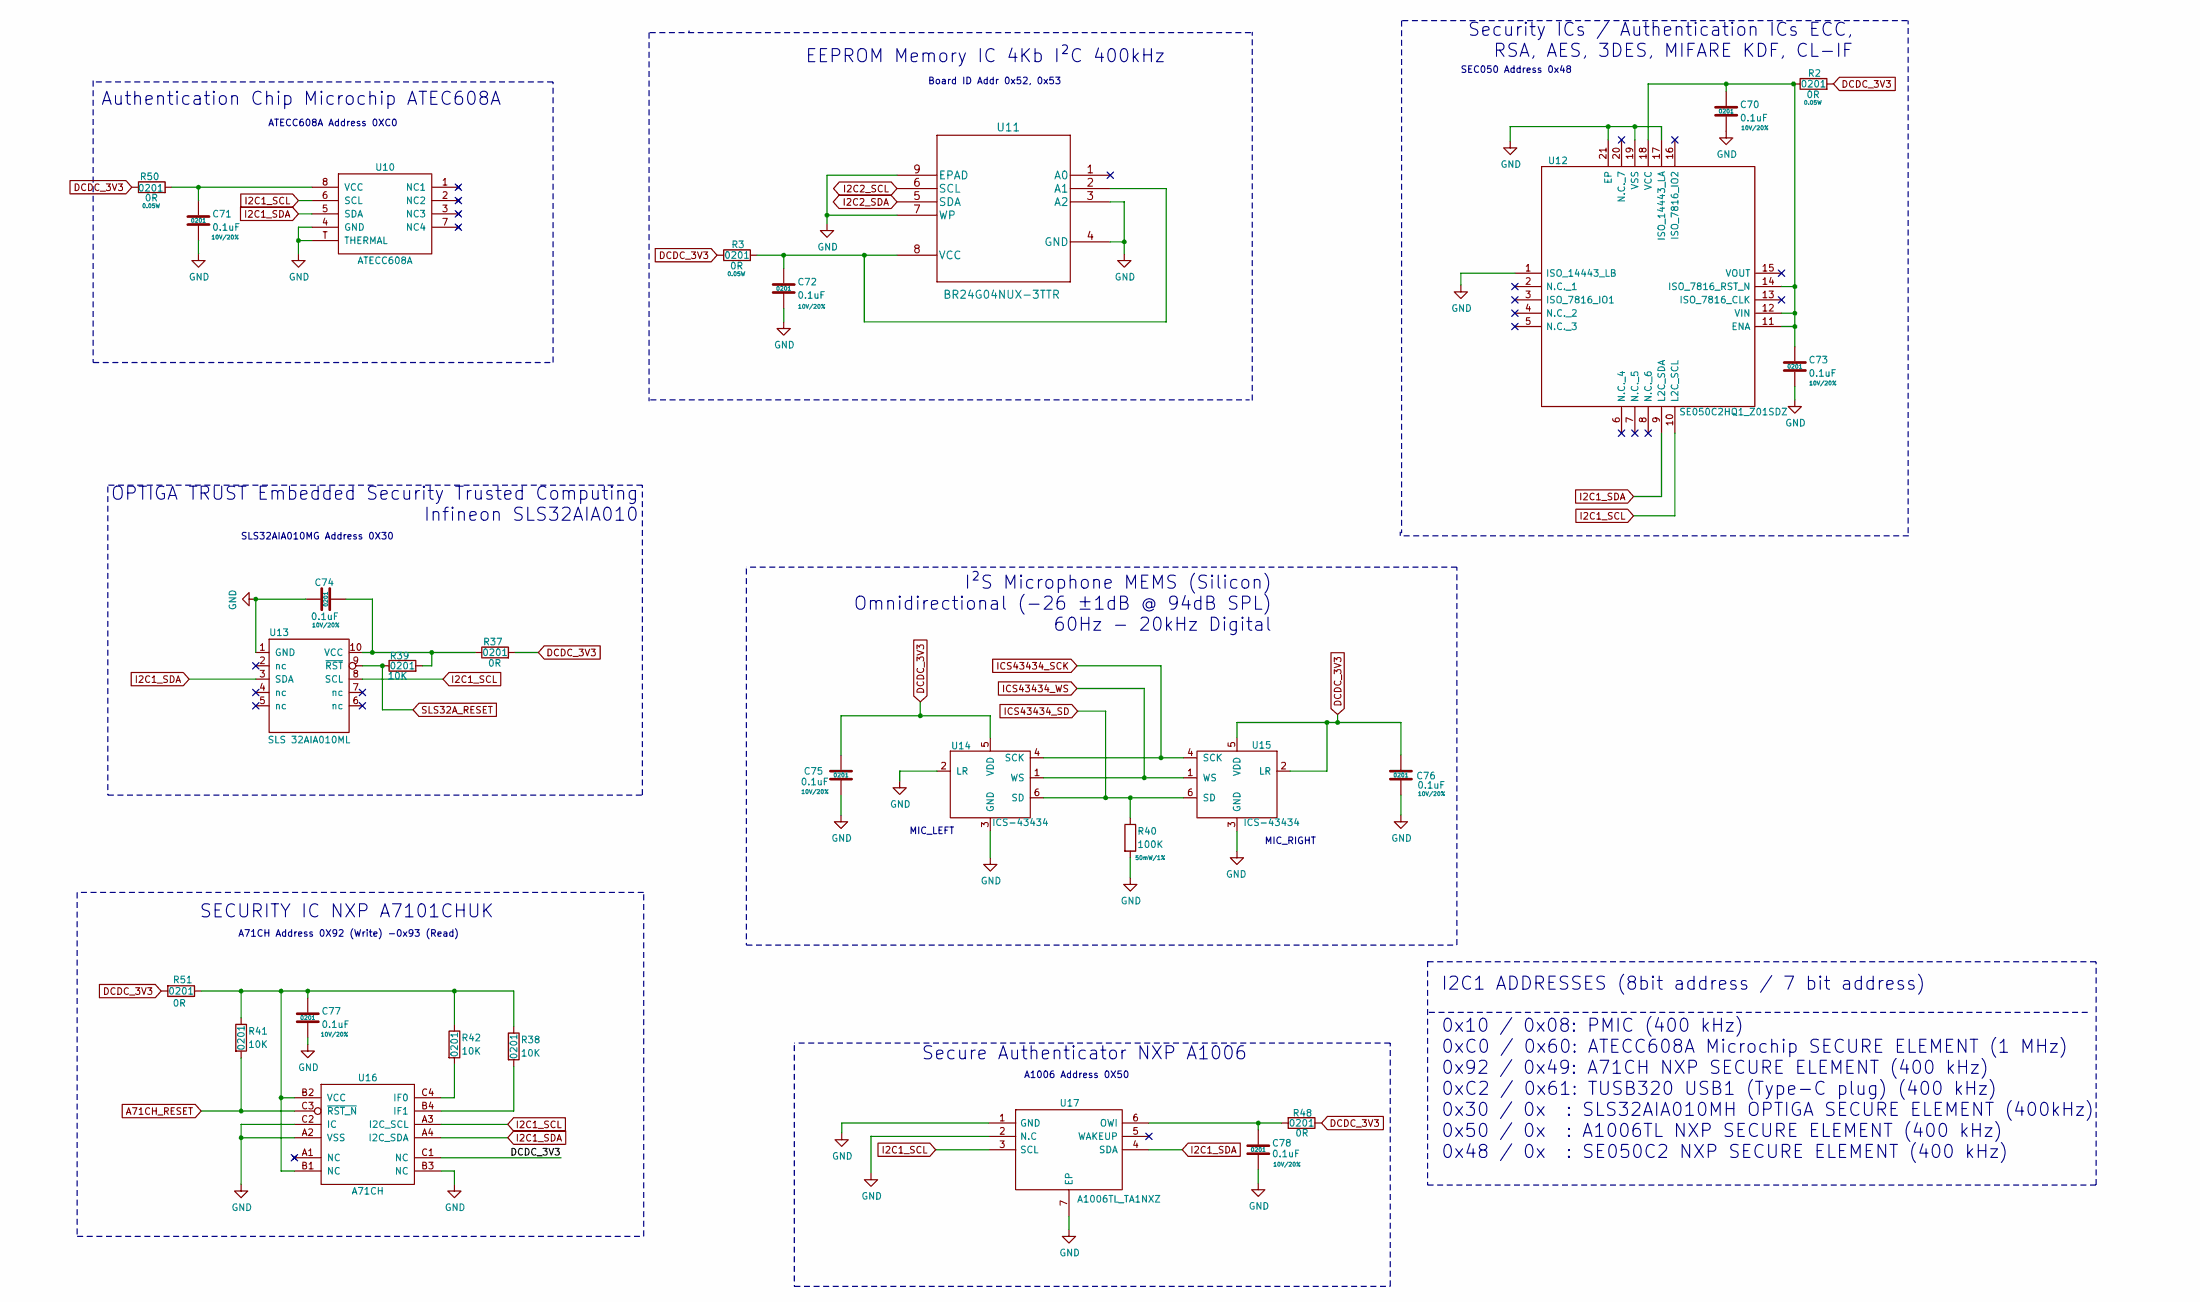
[picture p14: schematic secure-element.sch]

Parts:
C70, C71, C72, C73, C74, C75, C76, C77, C78: 0.1uF; SM0201; Rating 10V/20%; Mfg PN GRM033R61A104ME15D; Digi-Key_PN 490-5405-1-ND
R2, R3, R37, R50: 0R; R_0201_0603Metric; Rating 0.05W; Mfg PN CRCW02010000Z0ED; Digi-Key_PN 541-0.0AGCT-ND
R38, R39, R41, R42: 10K; R_0201_0603Metric; Rating 50mW/1%; Mfg PN CRCW020110K0JNED; Digi-Key_PN 541-10KAGCT-ND
R40: 100K; R_0201_0603Metric; Rating 50mW/1%; Mfg PN CRCW0201100KJNED; Digi-Key_PN 541-100KAGCT-ND
R48, R51: 0R; R_0201_0603Metric; Rating 50mW/1%; Mfg PN CRCW020110K0JNED; Digi-Key_PN 541-10KAGCT-ND
U10: ATECC608A; UDFN-8; Mfg PN ATECC608A-MAHDA; Digi-Key_PN ATECC608A-MAHDA-SCT-ND
U11: BR24G04NUX-3TTR; Mfg PN BR24G04NUX-3TTR; Digi-Key_PN BR24G04NUX-3TCT-ND
U12: SE050C2HQ1_Z01SDZ; QFN40P300X300X33-21N-D; Mfg PN SE050C2HQ1/Z01SDZ; Digi-Key_PN 568-15378-1-ND
U13: SLS 32AIA010ML; SLS; Mfg PN SLS32AIA010MH
U14, U15: ICS-43434; ICS43434; Mfg PN ICS-43434; Digi-Key_PN 1428-1066-1-ND
U16: A71CH; SOT1999-1; Mfg PN A7101CHUK/T0BC2HAZ; Digi-Key_PN 568-14698-1-ND
U17: A1006TL_TA1NXZ; SON65P200X200X50-7N; Mfg PN A1006TL/TA1NXZ; Digi-Key_PN 568-13635-1-ND

Connections:
A71CH_RESET: R41.2, U16.C3 (~RST_N)
DCDC_3V3: C75.2, C76.2, R2.2, R3.1, R37.2, R48.1, R50.1, R51.2, U14.5 (VDD), U15.2 (LR), U15.5 (VDD), U16.C1 (NC)
GND: C70.2, C71.2, C72.2, C73.2, C74.1, C75.1, C76.1, C77.2, C78.2, R40.2, U10.4 (GND), U10.T (THERMAL), U11.3 (A2), U11.4 (GND), U11.7 (WP), U11.9 (EPAD), U12.1 (ISO_14443_LB), U12.17 (ISO_14443_LA), U12.19 (VSS), U12.21 (EP), U13.1 (GND), U14.2 (LR), U14.3 (GND), U15.3 (GND), U16.A2 (VSS), U16.B3 (NC), U16.C2 (IC), U17.1 (GND), U17.2 (N.C), U17.7 (EP)
I2C1_SCL: U10.6 (SCL), U12.10 (L2C_SCL), U13.8 (SCL), U16.A3 (I2C_SCL), U17.3 (SCL)
I2C1_SDA: U10.5 (SDA), U12.9 (L2C_SDA), U13.3 (SDA), U16.A4 (I2C_SDA), U17.4 (SDA)
I2C2_SCL: U11.6 (SCL)
I2C2_SDA: U11.5 (SDA)
ICS43434_SCK: U14.4 (SCK), U15.4 (SCK)
ICS43434_SD: R40.1, U14.6 (SD), U15.6 (SD)
ICS43434_WS: U14.1 (WS), U15.1 (WS)
unnamed: C70.1, C73.1, R2.1, U12.11 (ENA), U12.12 (VIN), U12.14 (ISO_7816_RST_N), U12.18 (VCC)
unnamed: C71.1, R50.2, U10.8 (VCC)
unnamed: C72.1, R3.2, U11.2 (A1), U11.8 (VCC)
unnamed: C74.2, R37.1, R39.2, U13.10 (VCC)
unnamed: C77.1, R38.1, R41.1, R42.1, R51.1, U16.B1 (NC), U16.B2 (VCC)
unnamed: C78.1, R48.2, U17.6 (OWI)
unnamed: R38.2, U16.B4 (IF1)
unnamed: R42.2, U16.C4 (IF0)
SLS32A_RESET: R39.1, U13.9 (~RST)

Notes on the sheet:
SLS32AIA010MG Address 0X30
A71CH Address 0X92 (Write) -0x93 (Read)
ATECC608A Address 0XC0
A1006 Address 0X50
SEC050 Address 0x48
Board ID Addr 0x52, 0x53
I2C1 ADDRESSES (8bit address / 7 bit address) 0x10 / 0x08: PMIC (400 kHz) 0xC0 / 0x60: ATECC608A Microchip SECURE ELEMENT (1 MHz) 0x92 / 0x49: A71CH NXP SECURE ELEMENT (400 kHz) 0xC2 / 0x61: TUSB320 USB1 (Type-C plug) (400 kHz) 0x30 / 0x : SLS32AIA010MH OPTIGA SECURE ELEMENT (400kHz) 0x50 / 0x : A1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
Secure Authenticator NXP A1006
I²S Microphone MEMS (Silicon) Omnidirectional (-26 ±1dB @ 94dB SPL) 60Hz - 20kHz Digital
Security ICs / Authentication ICs ECC, RSA, AES, 3DES, MIFARE KDF, CL-IF
EEPROM Memory IC 4Kb I²C 400kHz
OPTIGA TRUST Embedded Security Trusted Computing Infineon SLS32AIA010
SECURITY IC NXP A7101CHUK
Authentication Chip Microchip ATEC608A
MIC_RIGHT
MIC_LEFT
