FranciscoVentures/EN7767/Hardware/usb.sch

## KiCad design Hardware/usb.sch (2021-01-12)

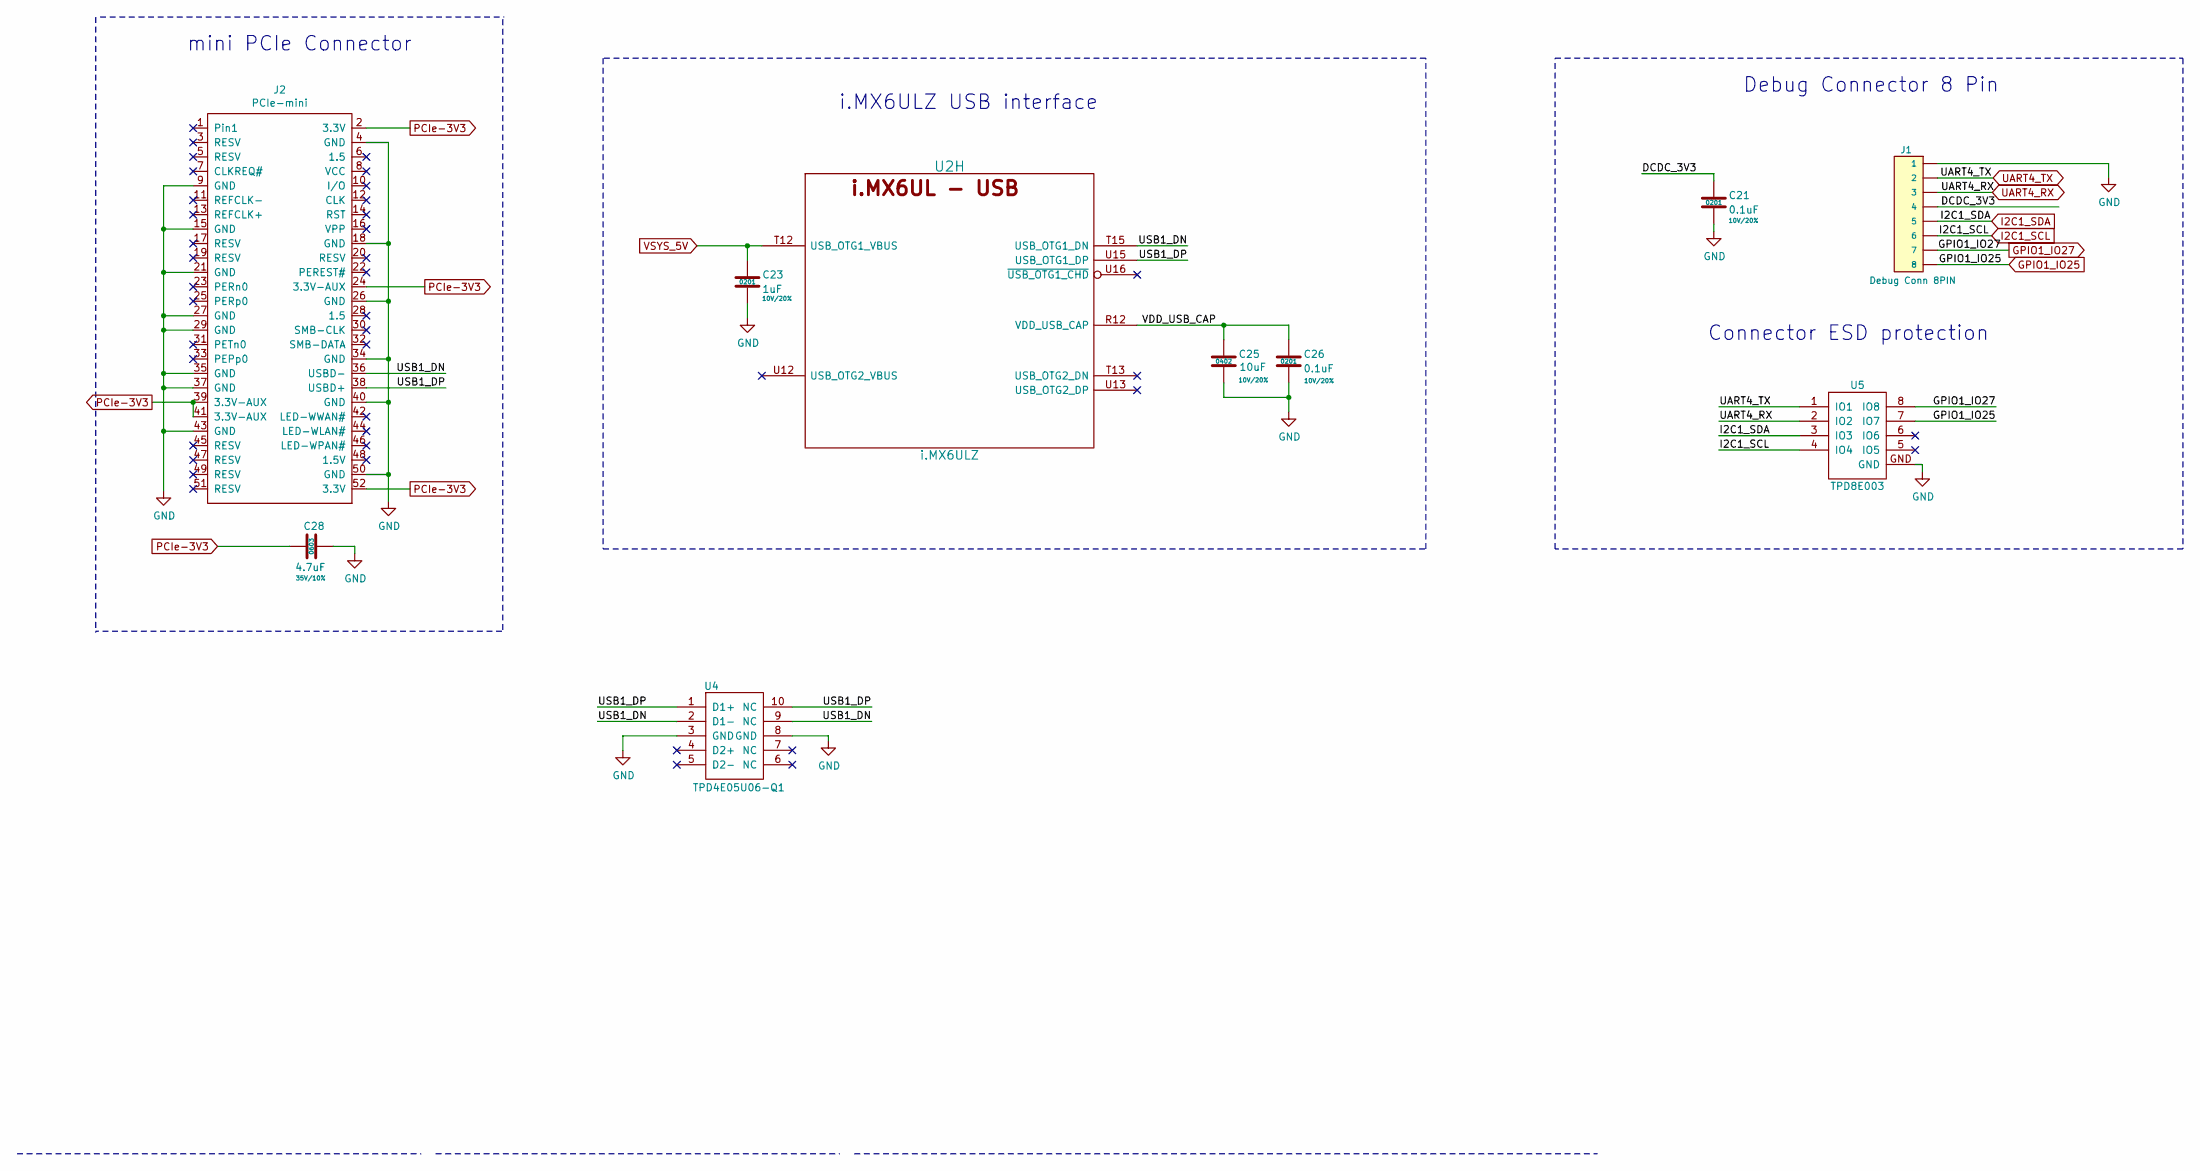
[picture p15: schematic usb.sch]

Parts:
C21, C26: 0.1uF; SM0201; Rating 10V/20%; Mfg PN GRM033R61A104ME15D; Digi-Key_PN 490-5405-1-ND
C23: 1uF; SM0201; Rating 10V/20%; Mfg PN CL03A105MP3ZSNH; Digi-Key_PN 1276-6816-1-ND
C25: 10uF; SM0402; Rating 10V/20%; Mfg PN CL05A106MP8NUB8; Digi-Key_PN 1276-6830-1-ND
C28: 4.7uF; SM0603; Rating 35V/10%; Mfg PN GRM188R6YA475KE15D; Digi-Key_PN 490-7205-1-ND
J1: Debug Conn 8PIN; BC075-08; Mfg PN BC075-08-A-L-A; Digi-Key_PN 2073-BC075-08-A-L-ACT-ND
J2: PCIe-mini; miniPCIeConn
U2: i.MX6ULZ; SOT1534-2; Mfg PN MCIMX6Z0DVM09AB; Digi-Key_PN 568-14726-ND
U4: TPD4E05U06-Q1; DQA-USON-10
U5: TPD8E003; WSON-8; Mfg PN TPD8E003DQDR; Digi-Key_PN 296-27669-1-ND

Connections:
DCDC_3V3: C21.1, J1.4
GND: C21.2, C23.2, C25.2, C26.2, C28.2, J1.1, J2.4 (GND), J2.9 (GND), J2.15 (GND), J2.18 (GND), J2.21 (GND), J2.26 (GND), J2.27 (GND), J2.29 (GND), J2.34 (GND), J2.35 (GND), J2.37 (GND), J2.40 (GND), J2.43 (GND), J2.50 (GND), U4.3 (GND), U4.8 (GND), U5.GND
GPIO1_IO25: J1.8, U5.7 (IO7)
GPIO1_IO27: J1.7, U5.8 (IO8)
I2C1_SCL: J1.6, U5.4 (IO4)
I2C1_SDA: J1.5, U5.3 (IO3)
PCIe-3V3: C28.1, J2.2 (3.3V), J2.24 (3.3V-AUX), J2.39 (3.3V-AUX), J2.41 (3.3V-AUX), J2.52 (3.3V)
UART4_RX: J1.3, U5.2 (IO2)
UART4_TX: J1.2, U5.1 (IO1)
USB1_DN: J2.36 (USBD-), U2.T15 (USB_OTG1_DN), U4.2 (D1-), U4.9 (NC)
USB1_DP: J2.38 (USBD+), U2.U15 (USB_OTG1_DP), U4.1 (D1+), U4.10 (NC)
VDD_USB_CAP: C25.1, C26.1, U2.R12 (VDD_USB_CAP)
VSYS_5V: C23.1, U2.T12 (USB_OTG1_VBUS)

Notes on the sheet:
mini PCIe Connector
Connector ESD protection
i.MX6ULZ USB interface
Debug Connector 8 Pin
