FranciscoVentures/EN7767/(notices)

Notices in the files:
Hardware/misc.sch:
License: CERN OHL v1.2
Hardware/power-tree.sch:
Copyright © 2019 F-Secure
